pedal-science/pedal-codec/LICENSING.md

# Licensing

This repository holds a hardware design and the software that supports it, so it carries two
licences, chosen by the pedal.science policy in
[../pedal.project/licensing/README.md](https://github.com/pedal-science/pedal.project/blob/main/licensing/README.md).
Both are permissive.

| Licence | Text | Covers |
|---|---|---|
| CERN-OHL-P-2.0 | [LICENSE-CERN-OHL-P](LICENSE-CERN-OHL-P) | Everything not listed below: `hardware/` (the KiCad project, libraries and fab outputs), `docs/`, `bench-results/` |
| MIT | [LICENSE-MIT](LICENSE-MIT) | `overlay/`, `scripts/`, `.github/` |

Copyright 2026 Rik Hemsley. Source location: https://github.com/pedal-science/pedal-codec

## Not ours

- The TAC5242 and every other part's datasheet are their makers' work, and are linked rather than
  kept here.
- KiCad's own symbol, footprint and 3D model libraries stay under KiCad's library licence
  (CC-BY-SA 4.0 with its exception for designs that use them).
