pedal-science/pedal-codec/hardware/pedal-codec.pdf

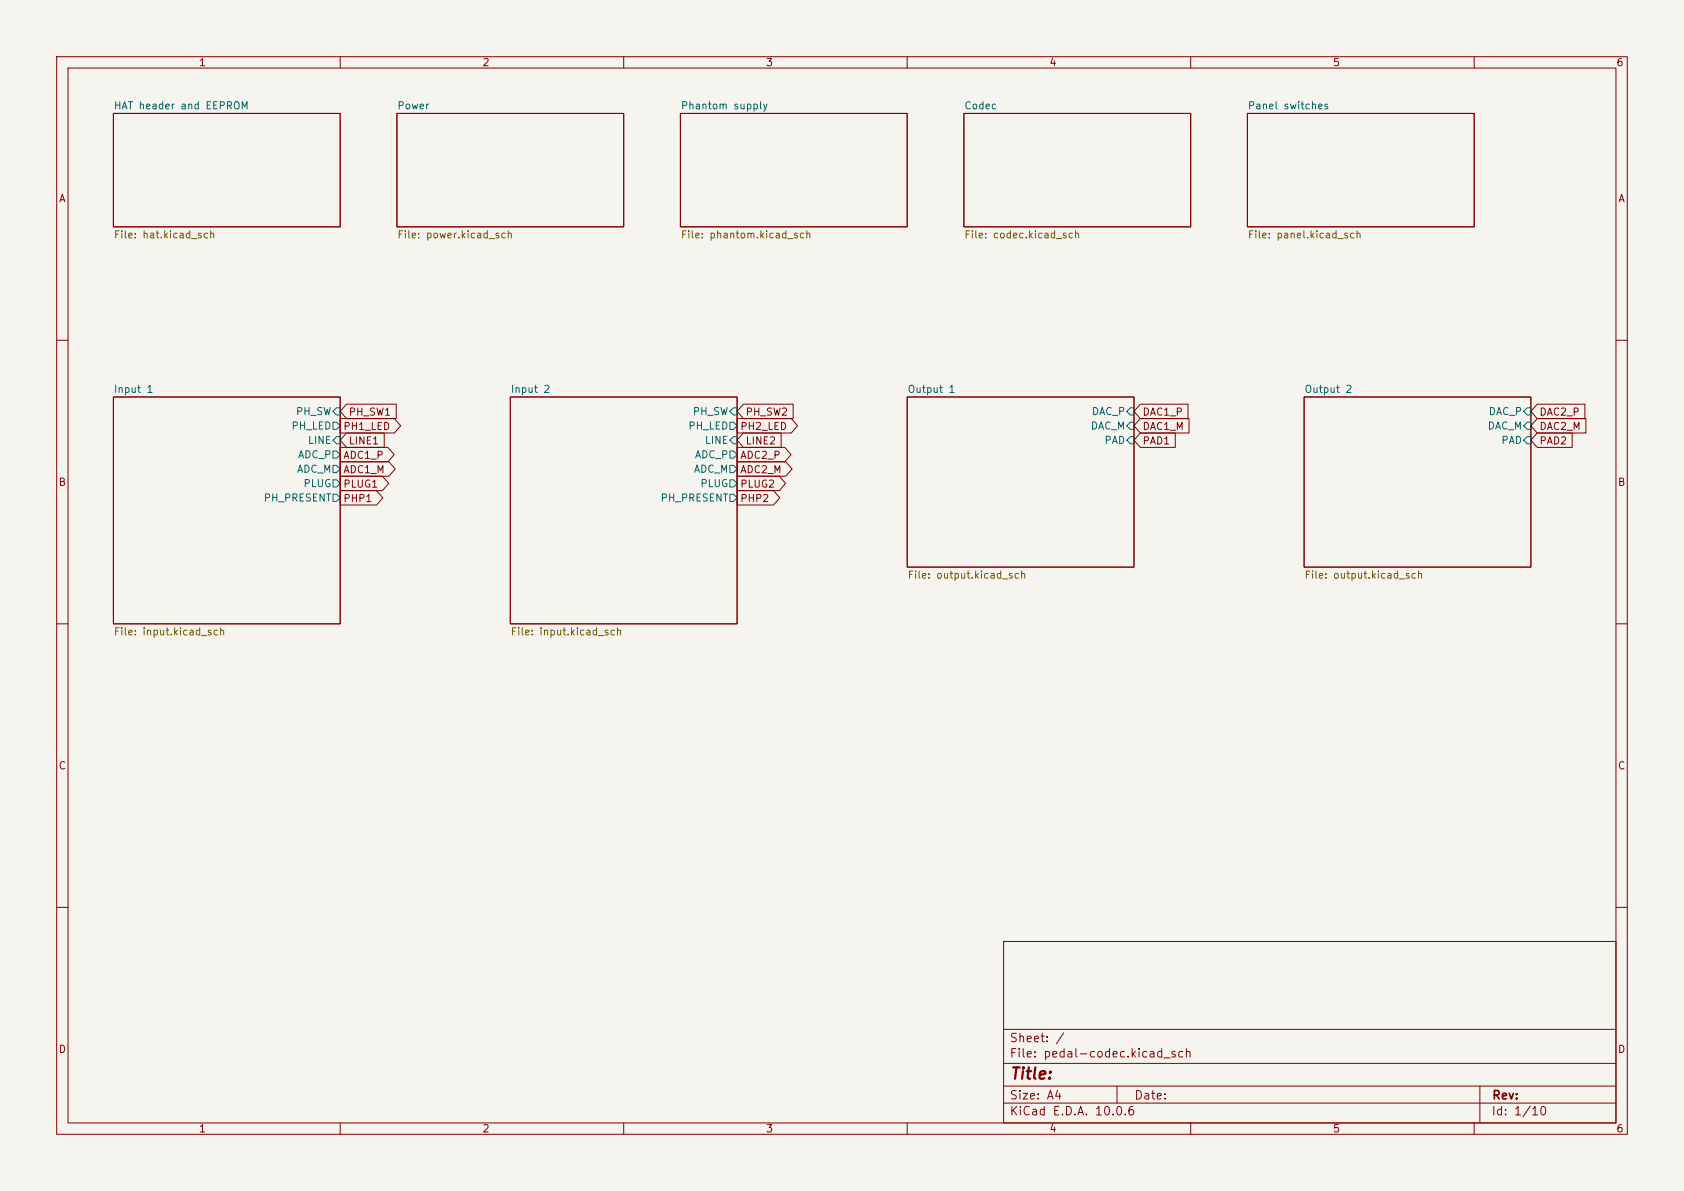
[picture p1: page 1]

File: codec.kicad_sch Phantom supply File: phantom.kicad_sch HAT header and EEPROM

Size: A4 | Rev:
KiCad E.D.A. 10.0.6 | Id: 1/10

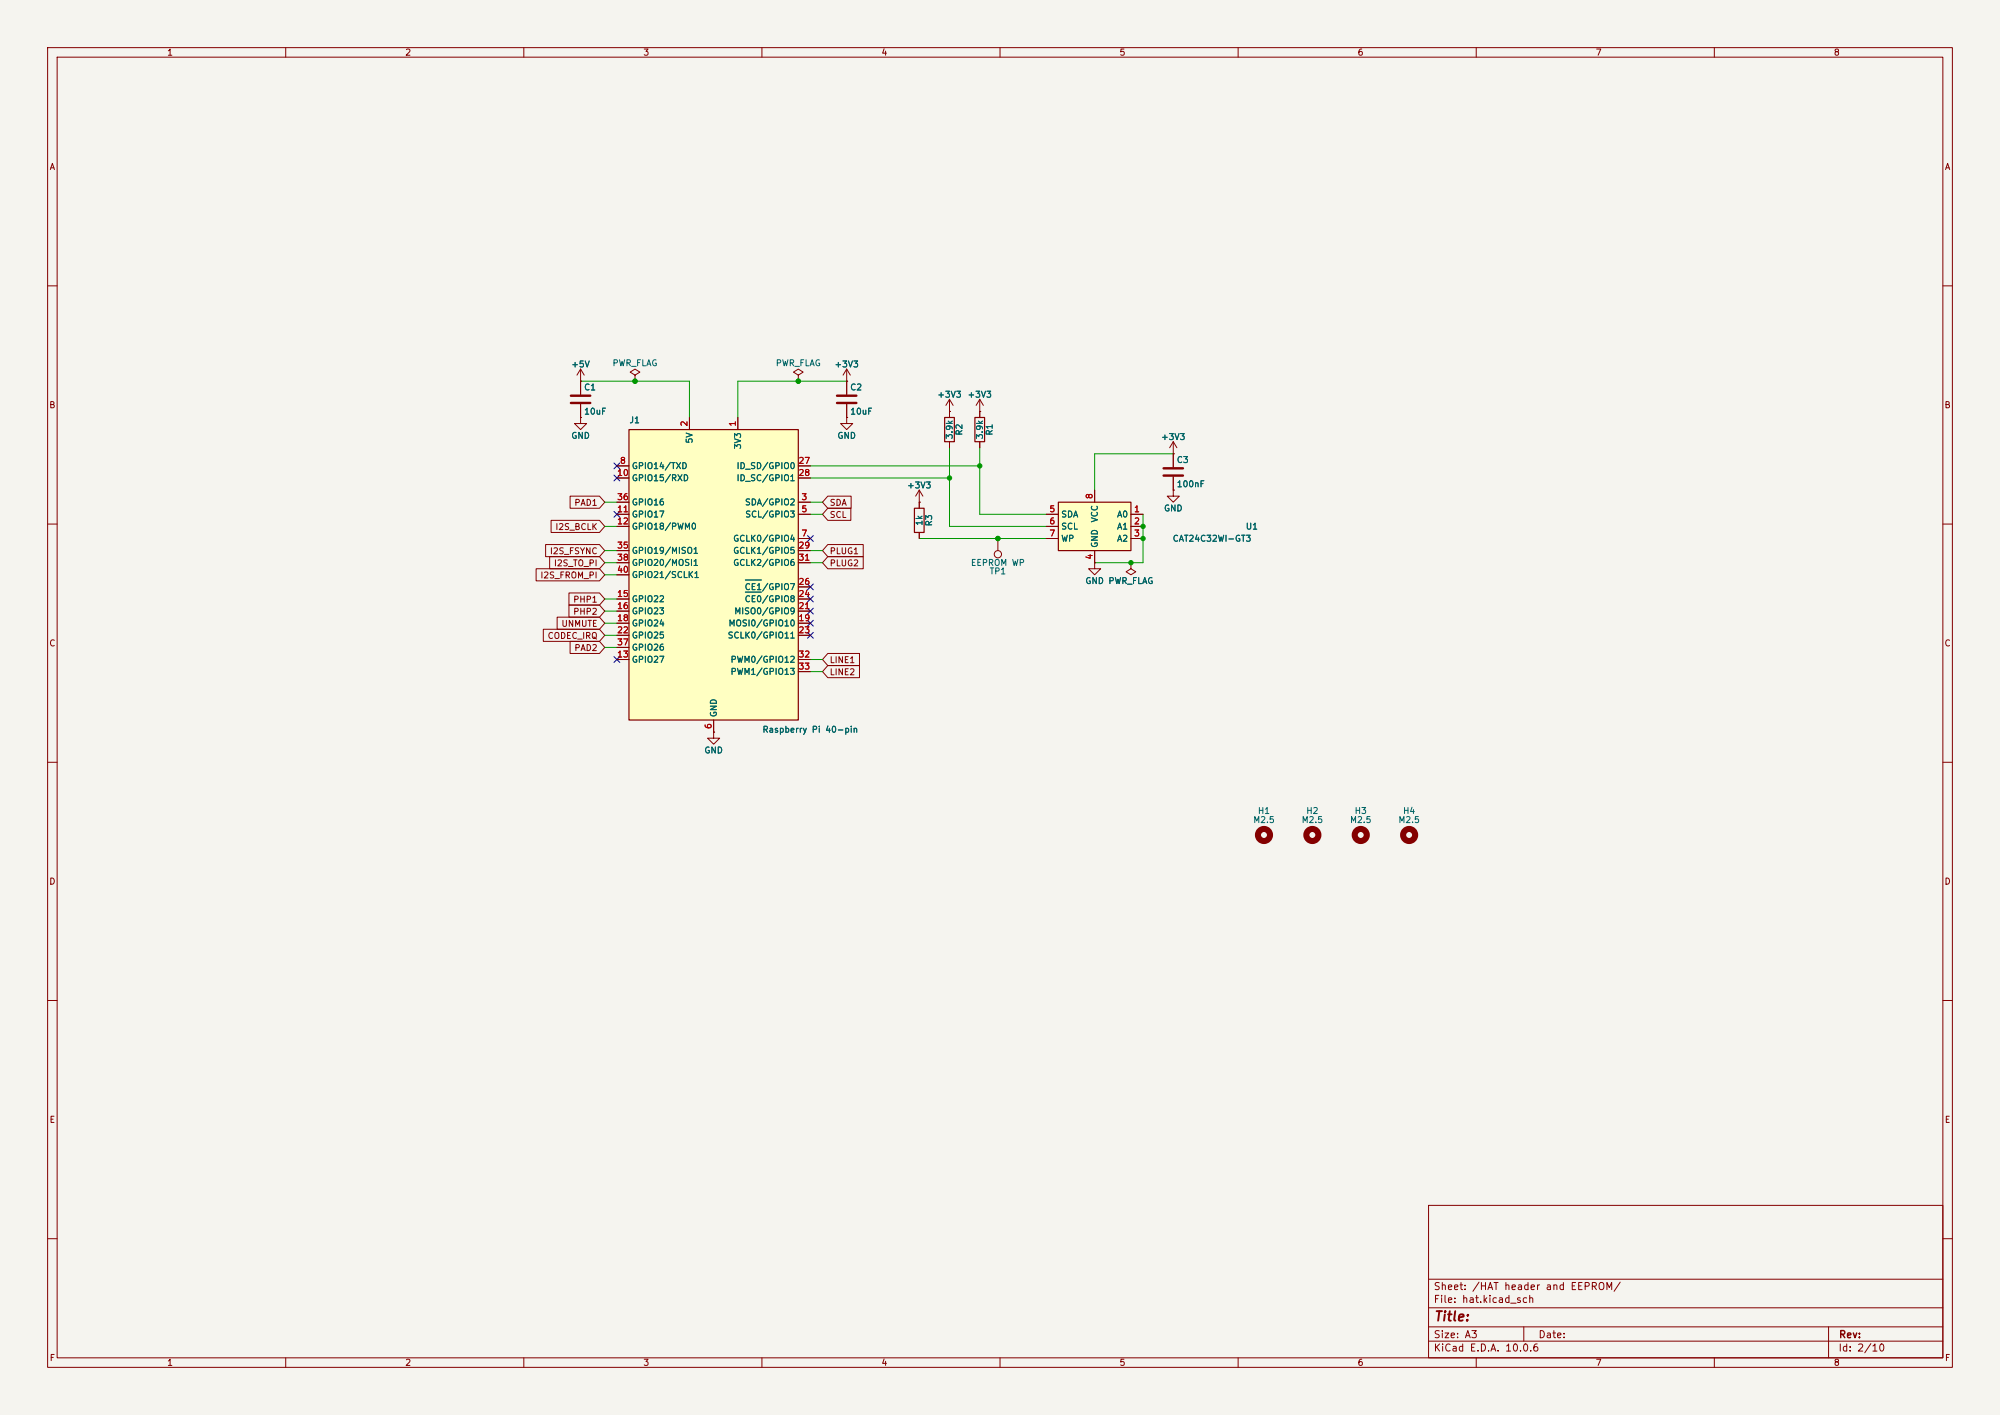
[picture p2: page 2]

Sheet: /HAT header and EEPROM/
File: hat.kicad_sch
Title:

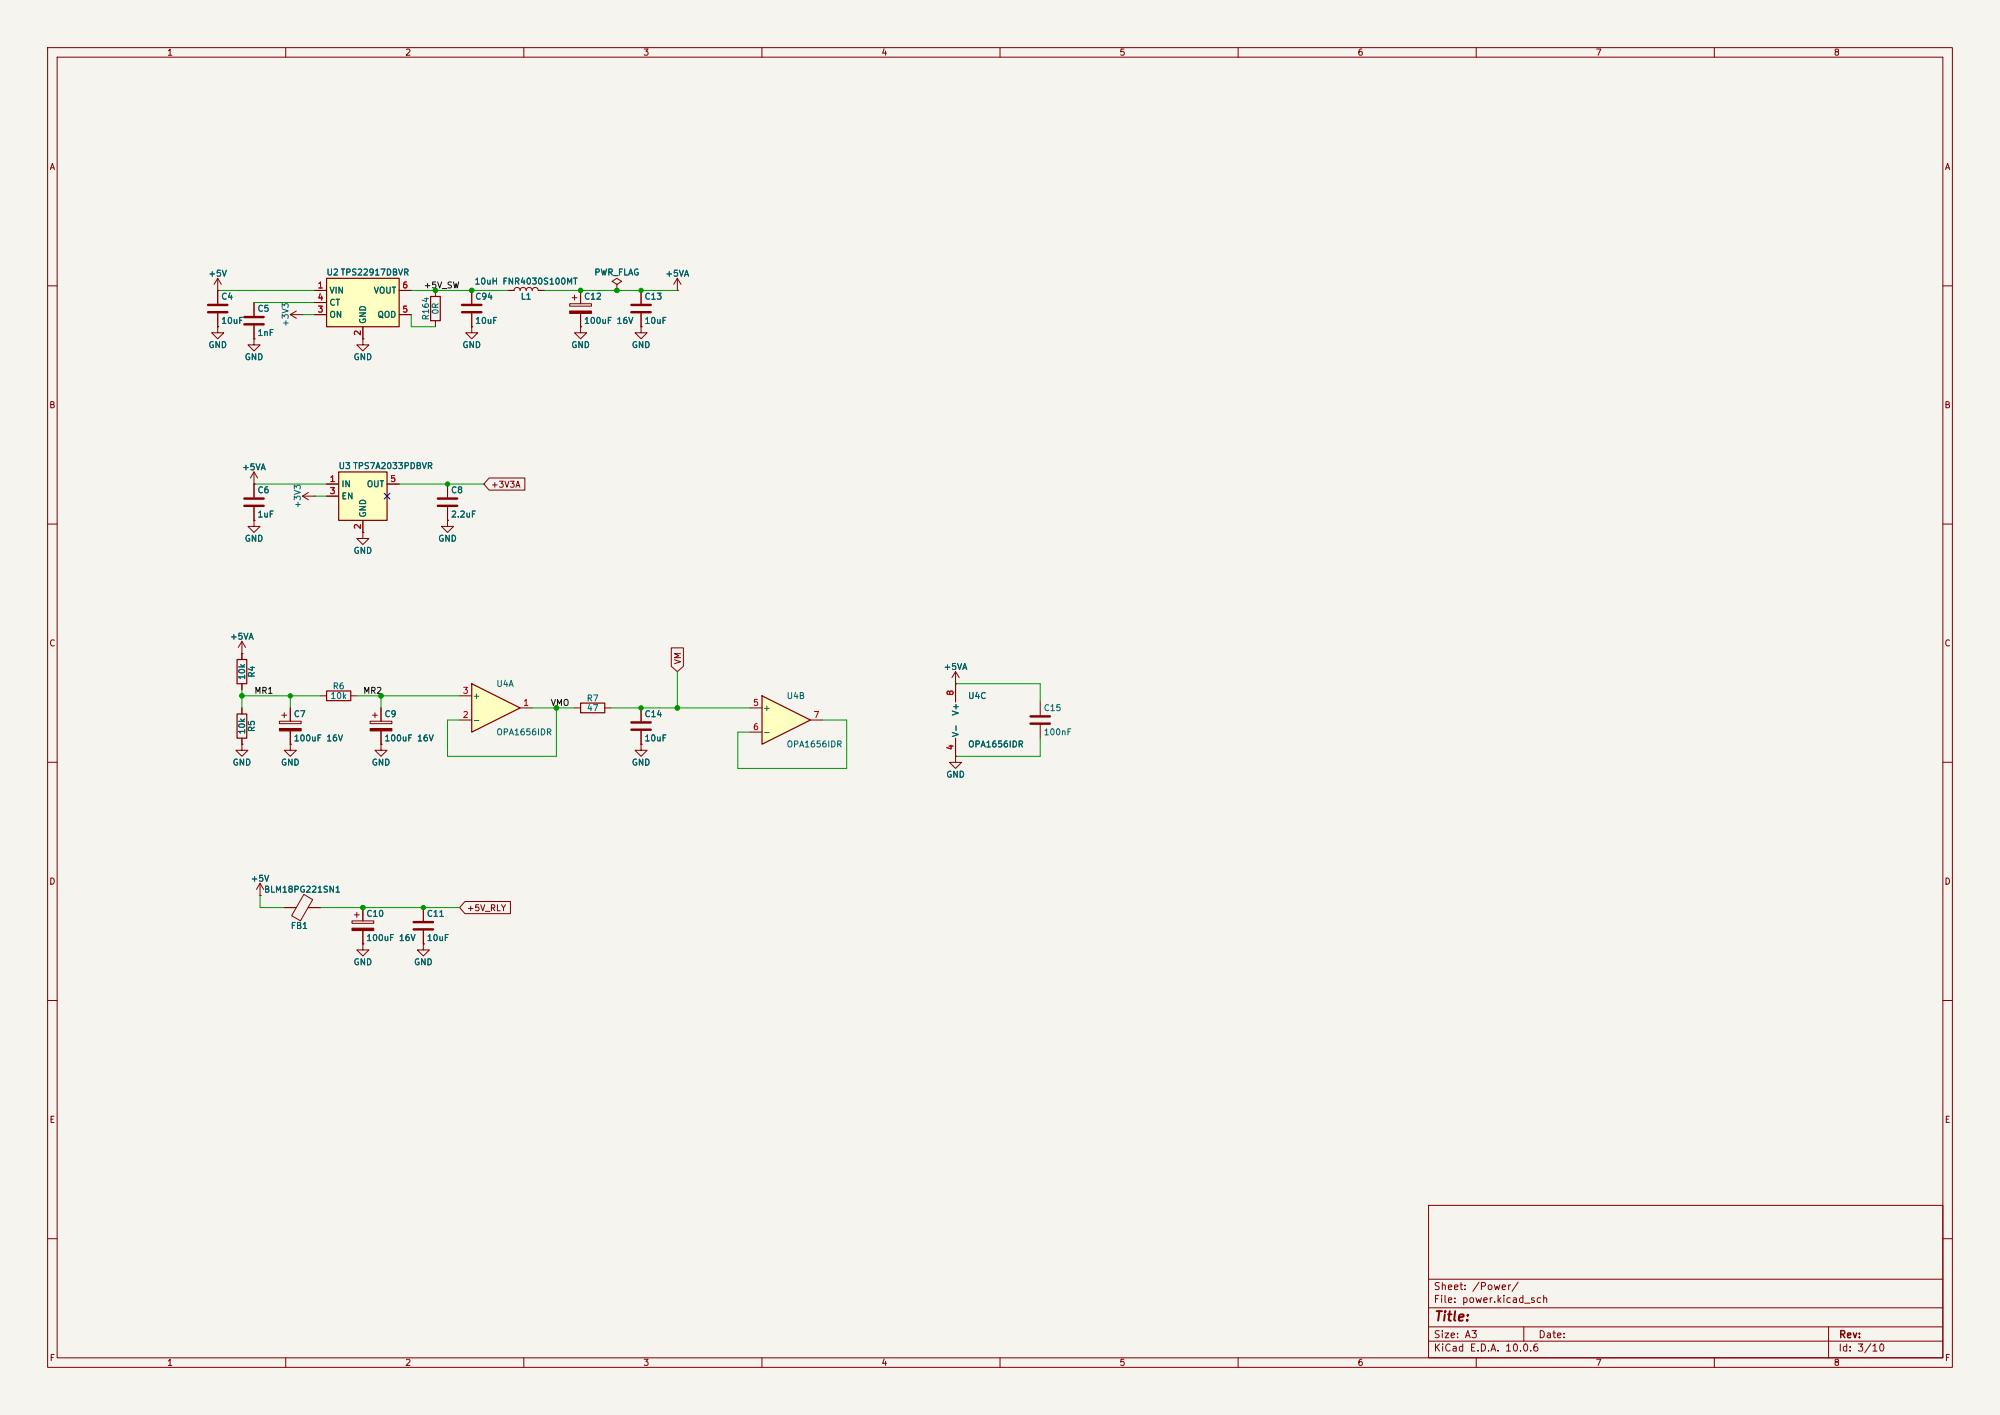
[picture p3: page 3]

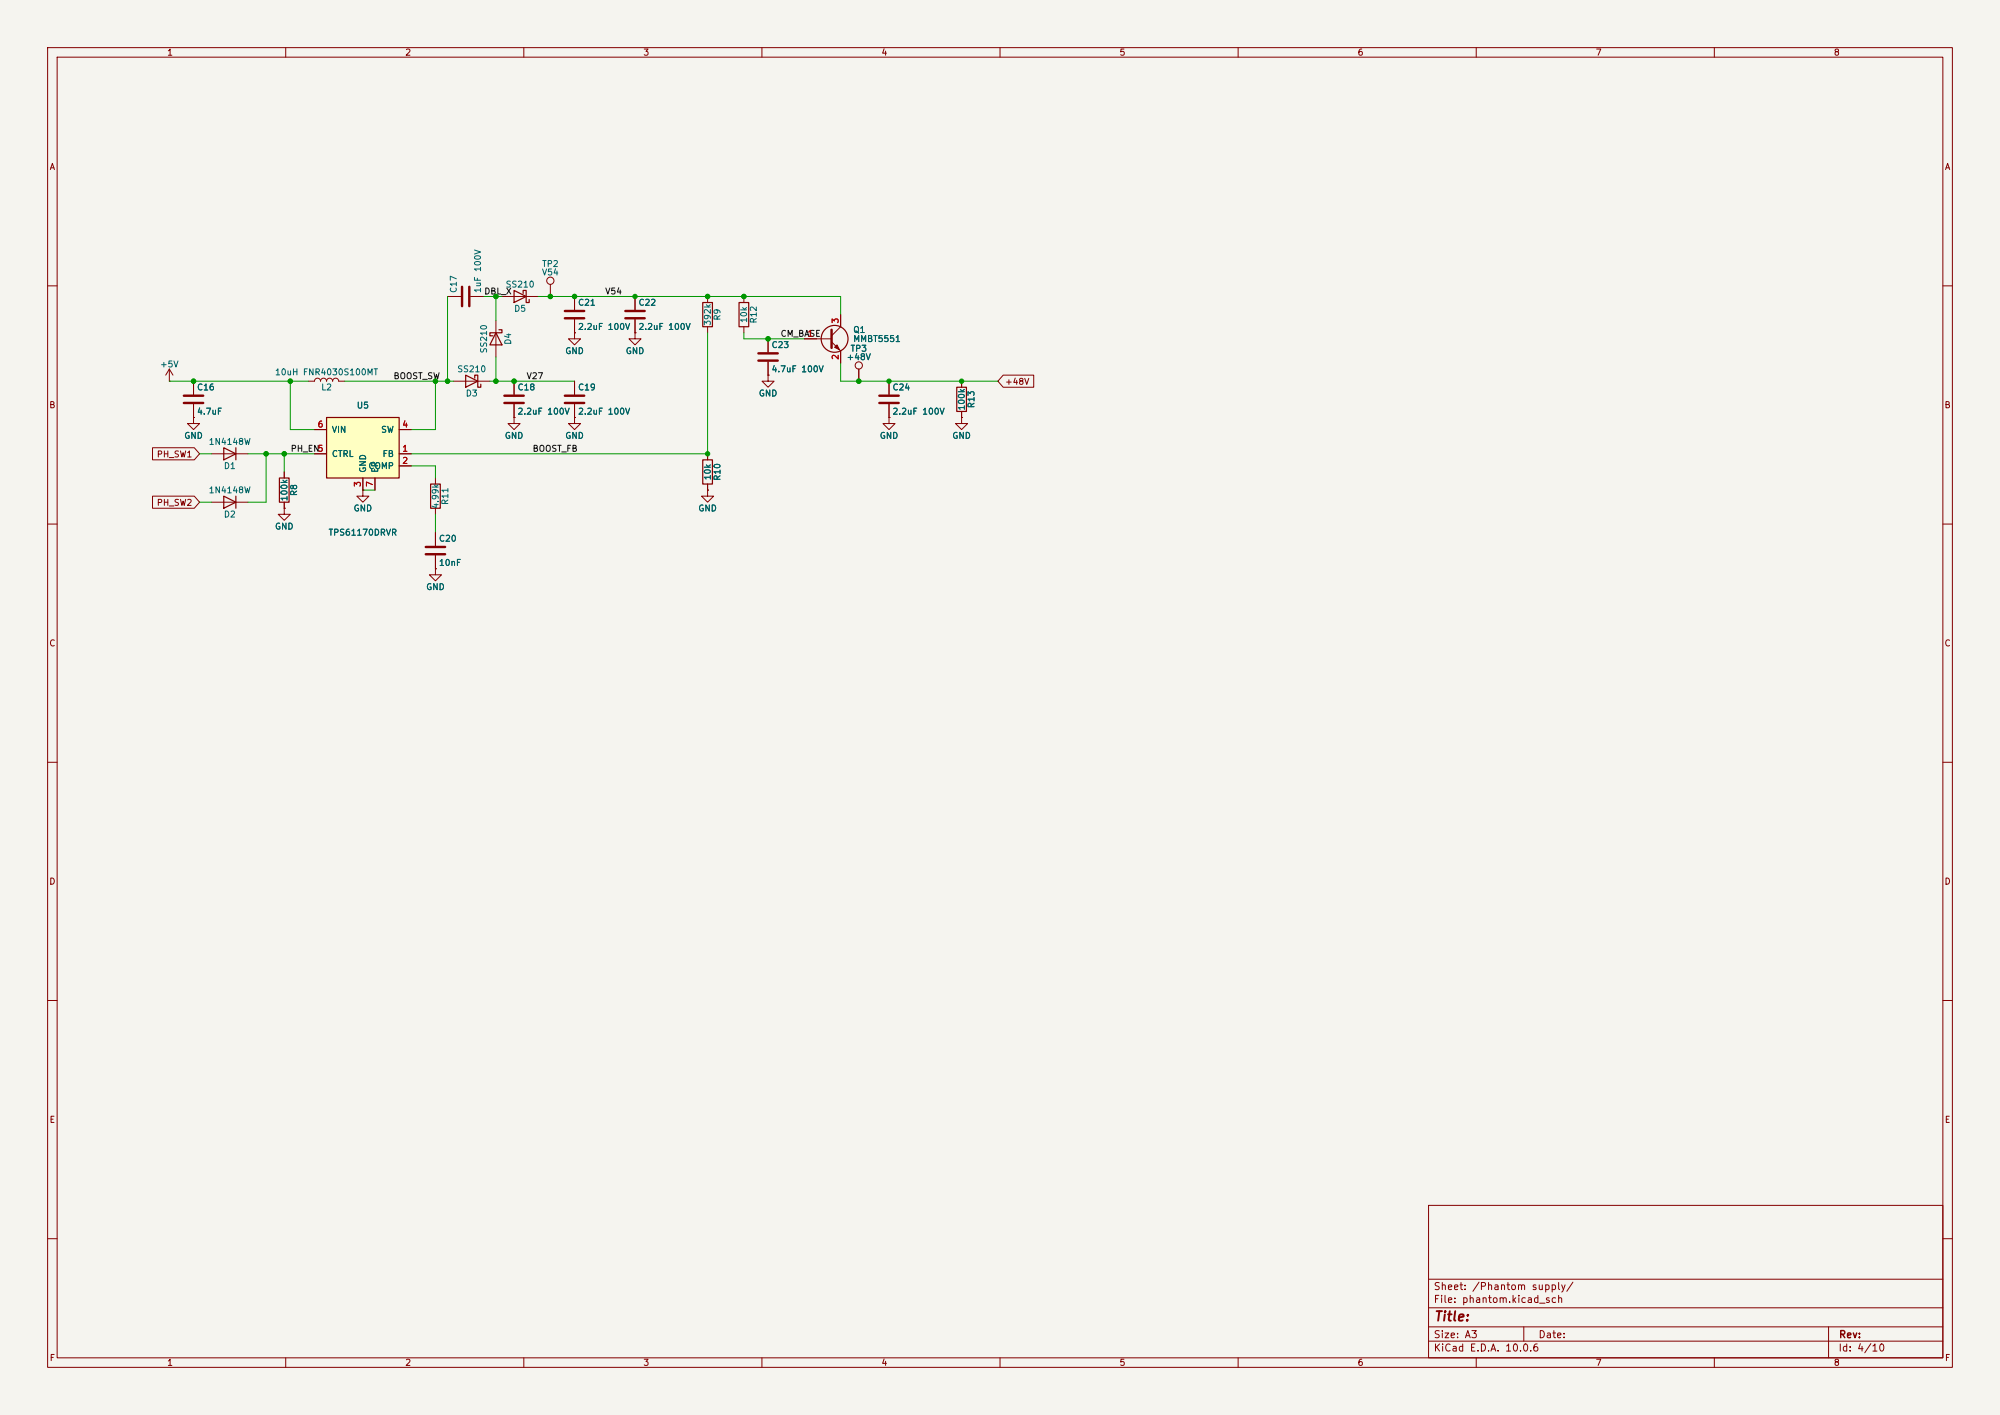
[picture p4: page 4]

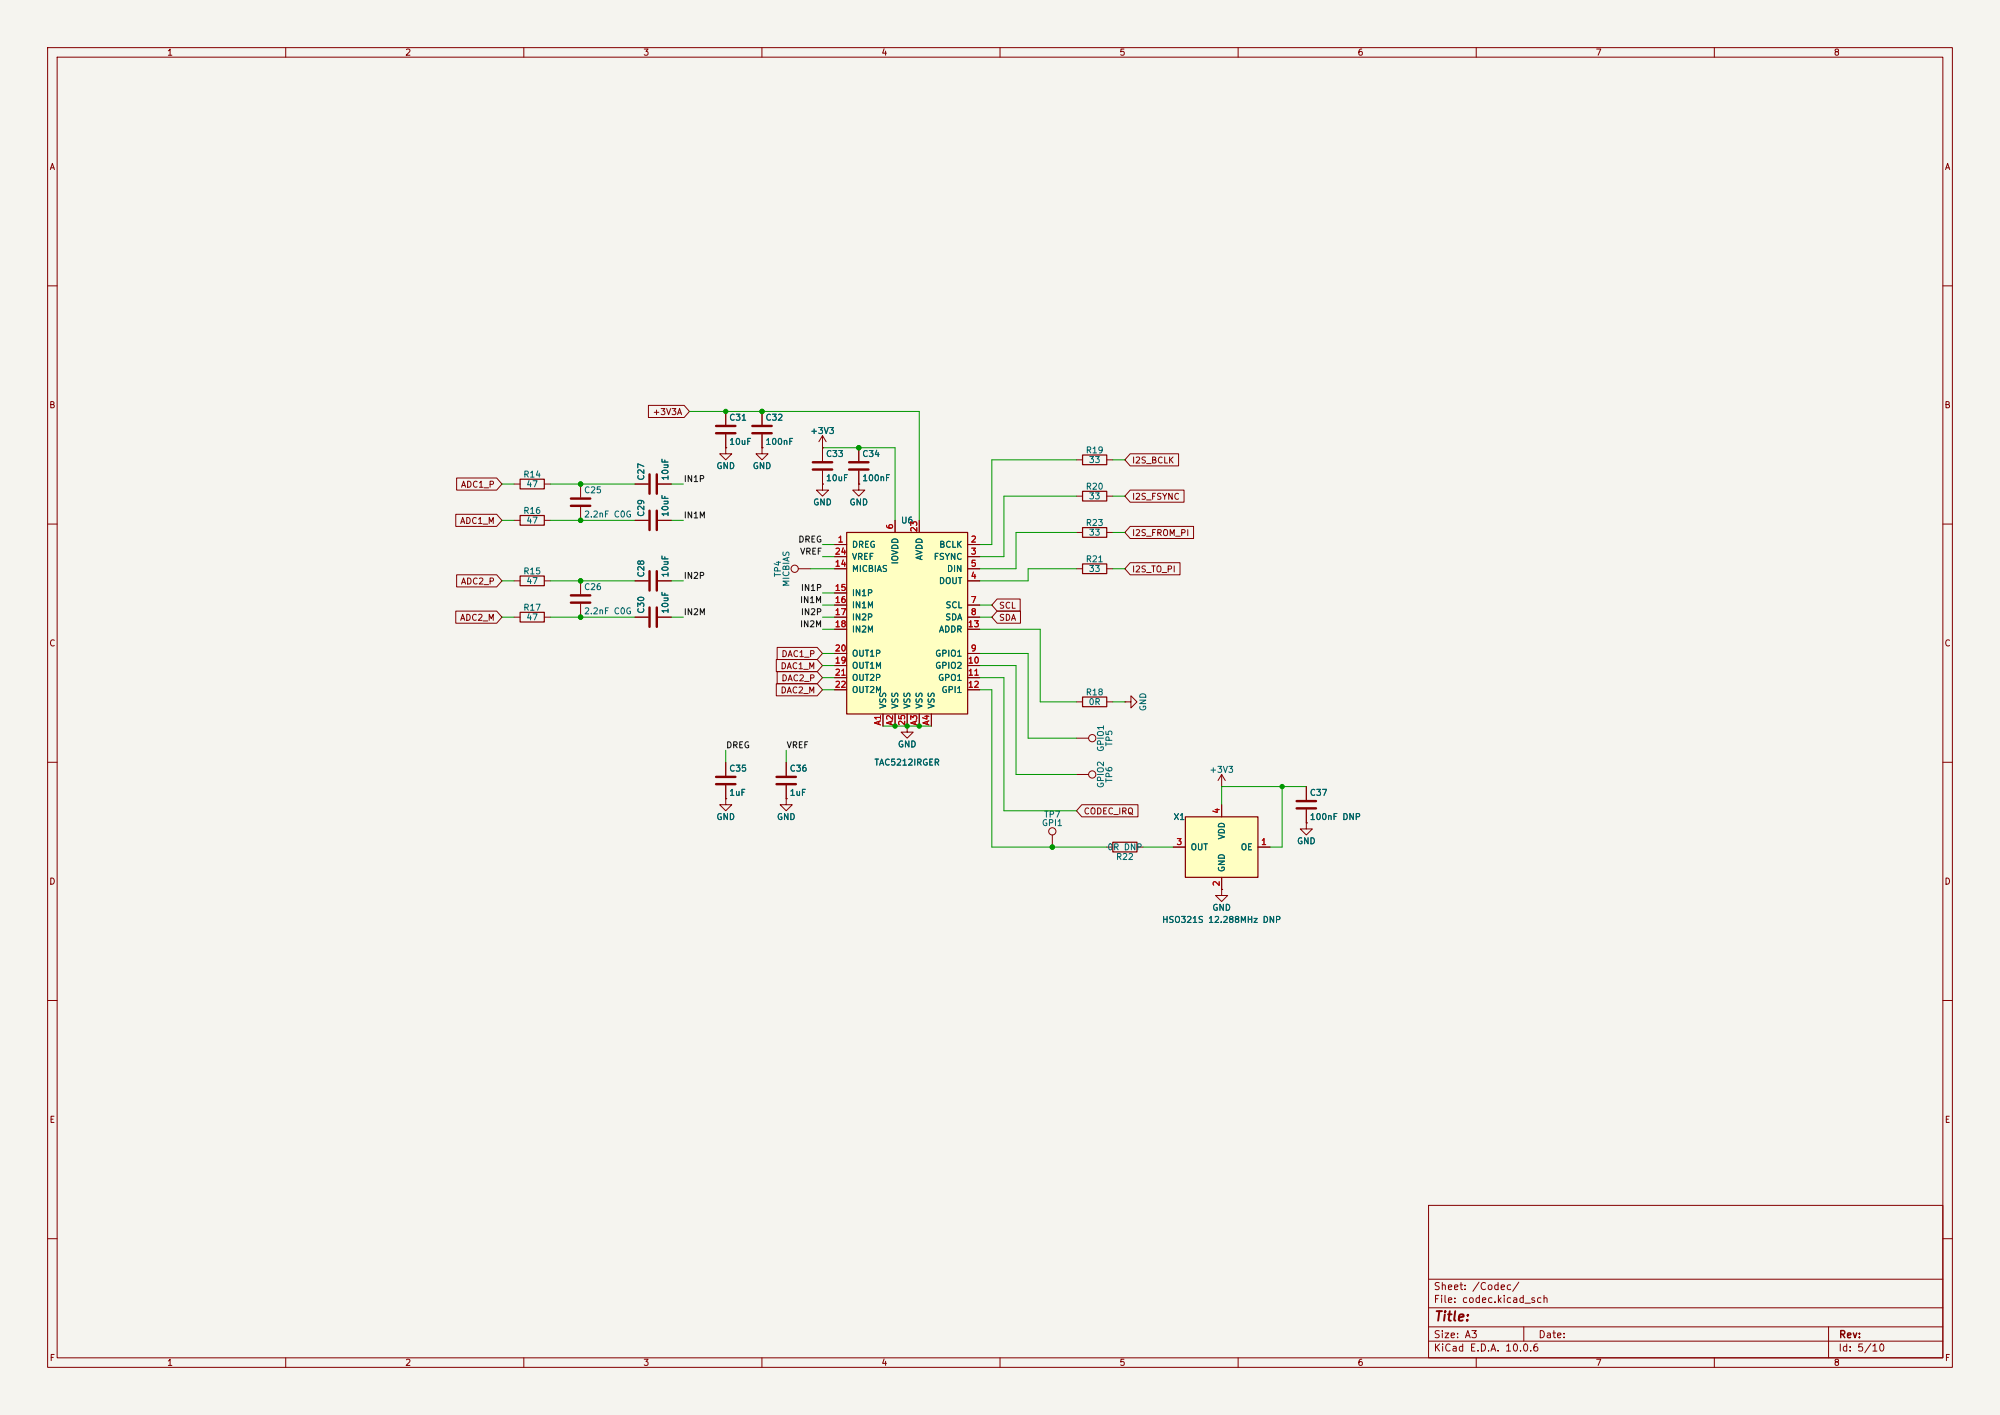
[picture p5: page 5]

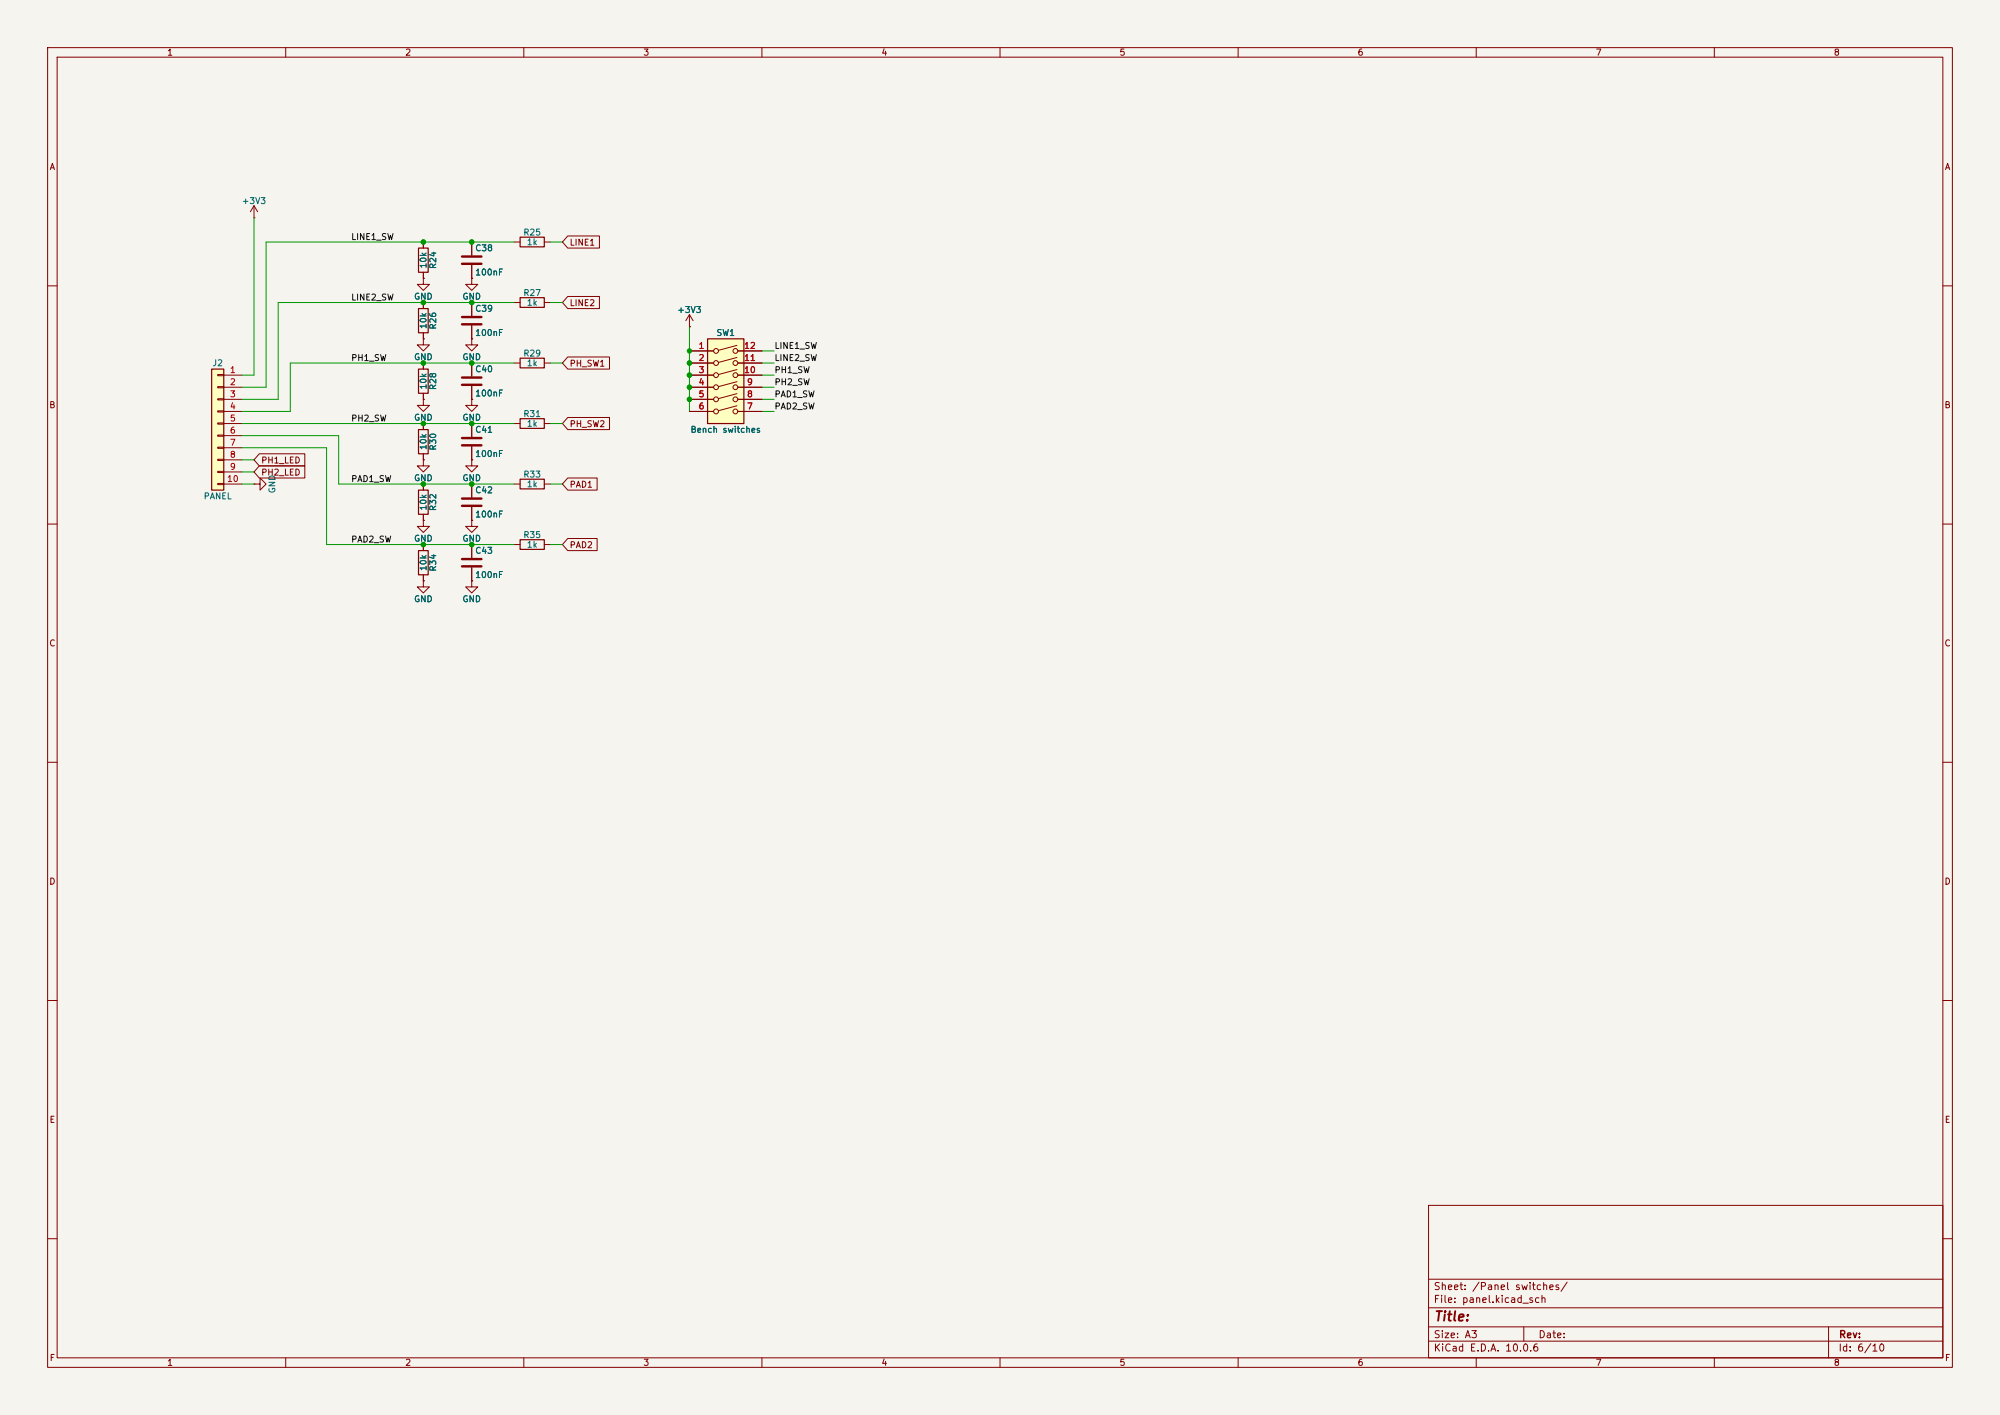
[picture p6: page 6]

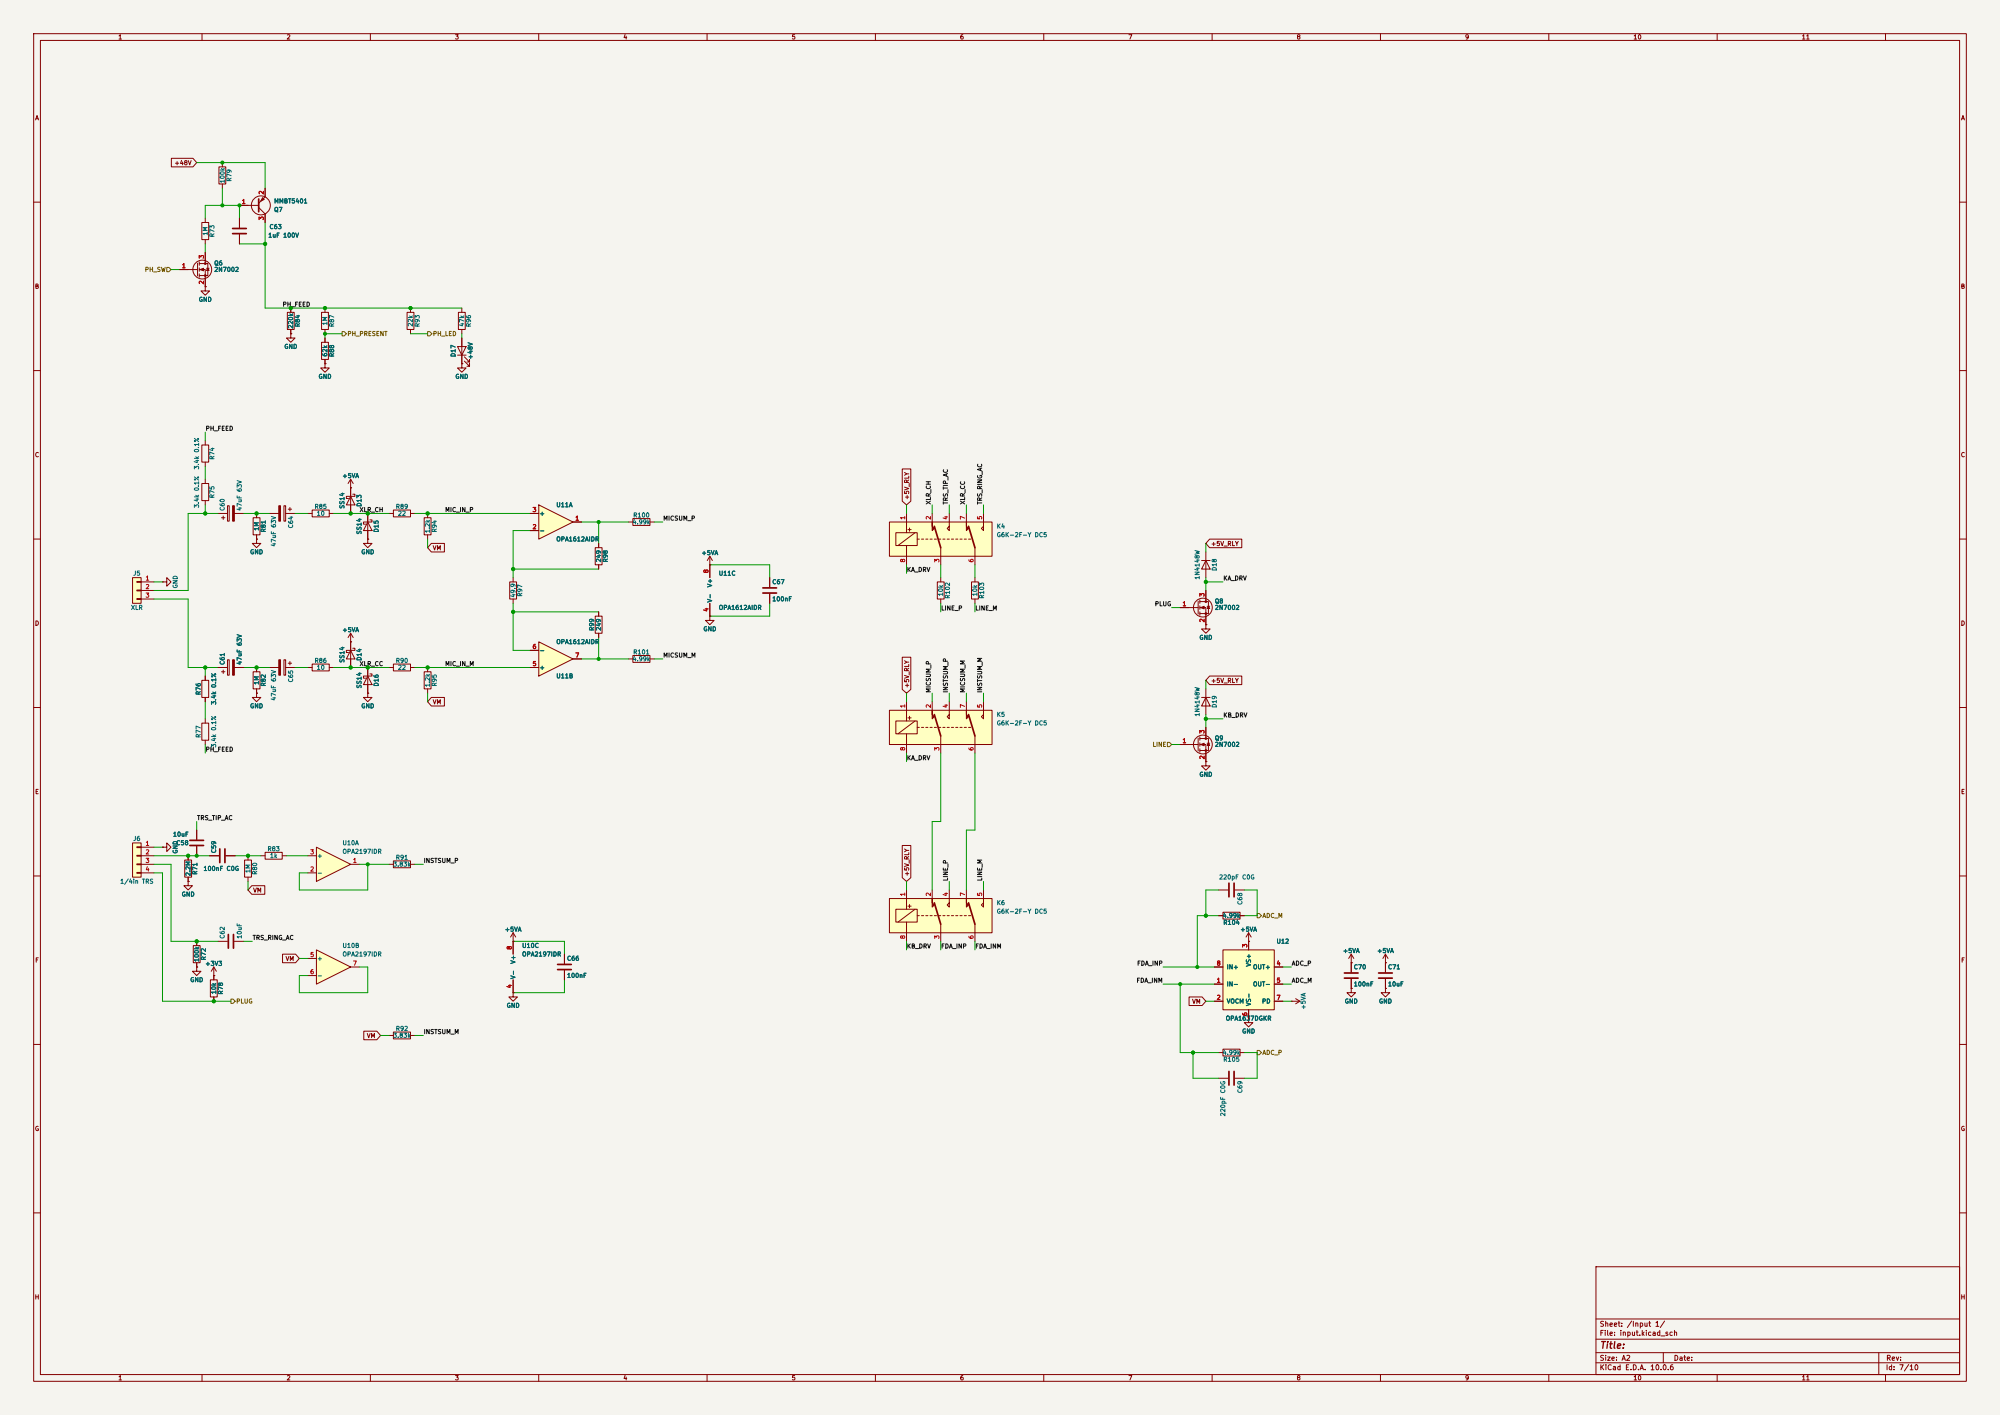
[picture p7: page 7]

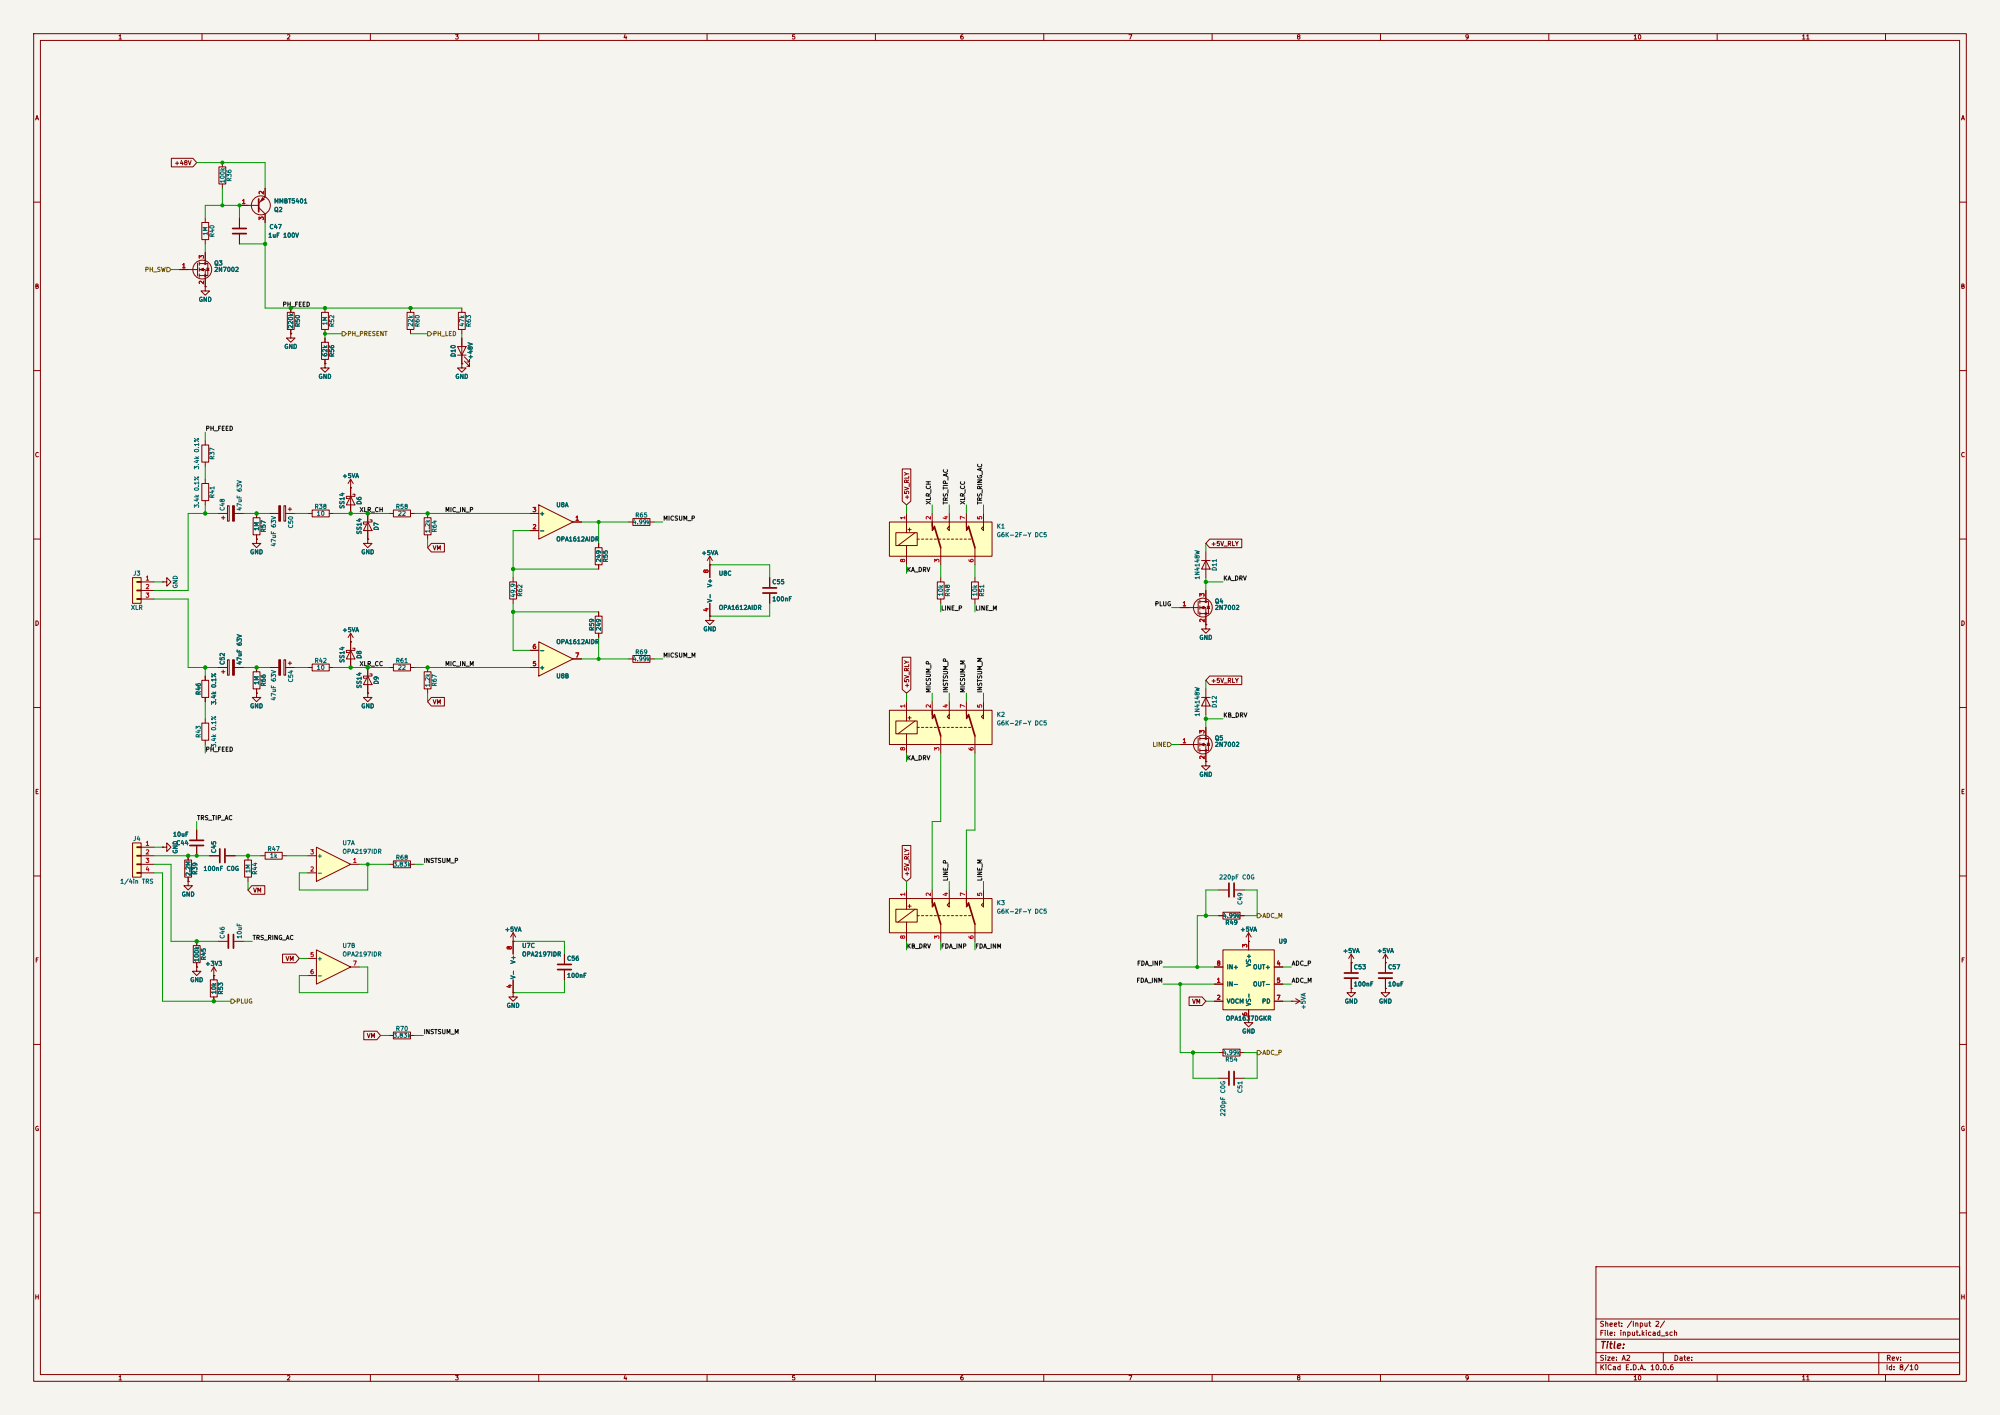
[picture p8: page 8]

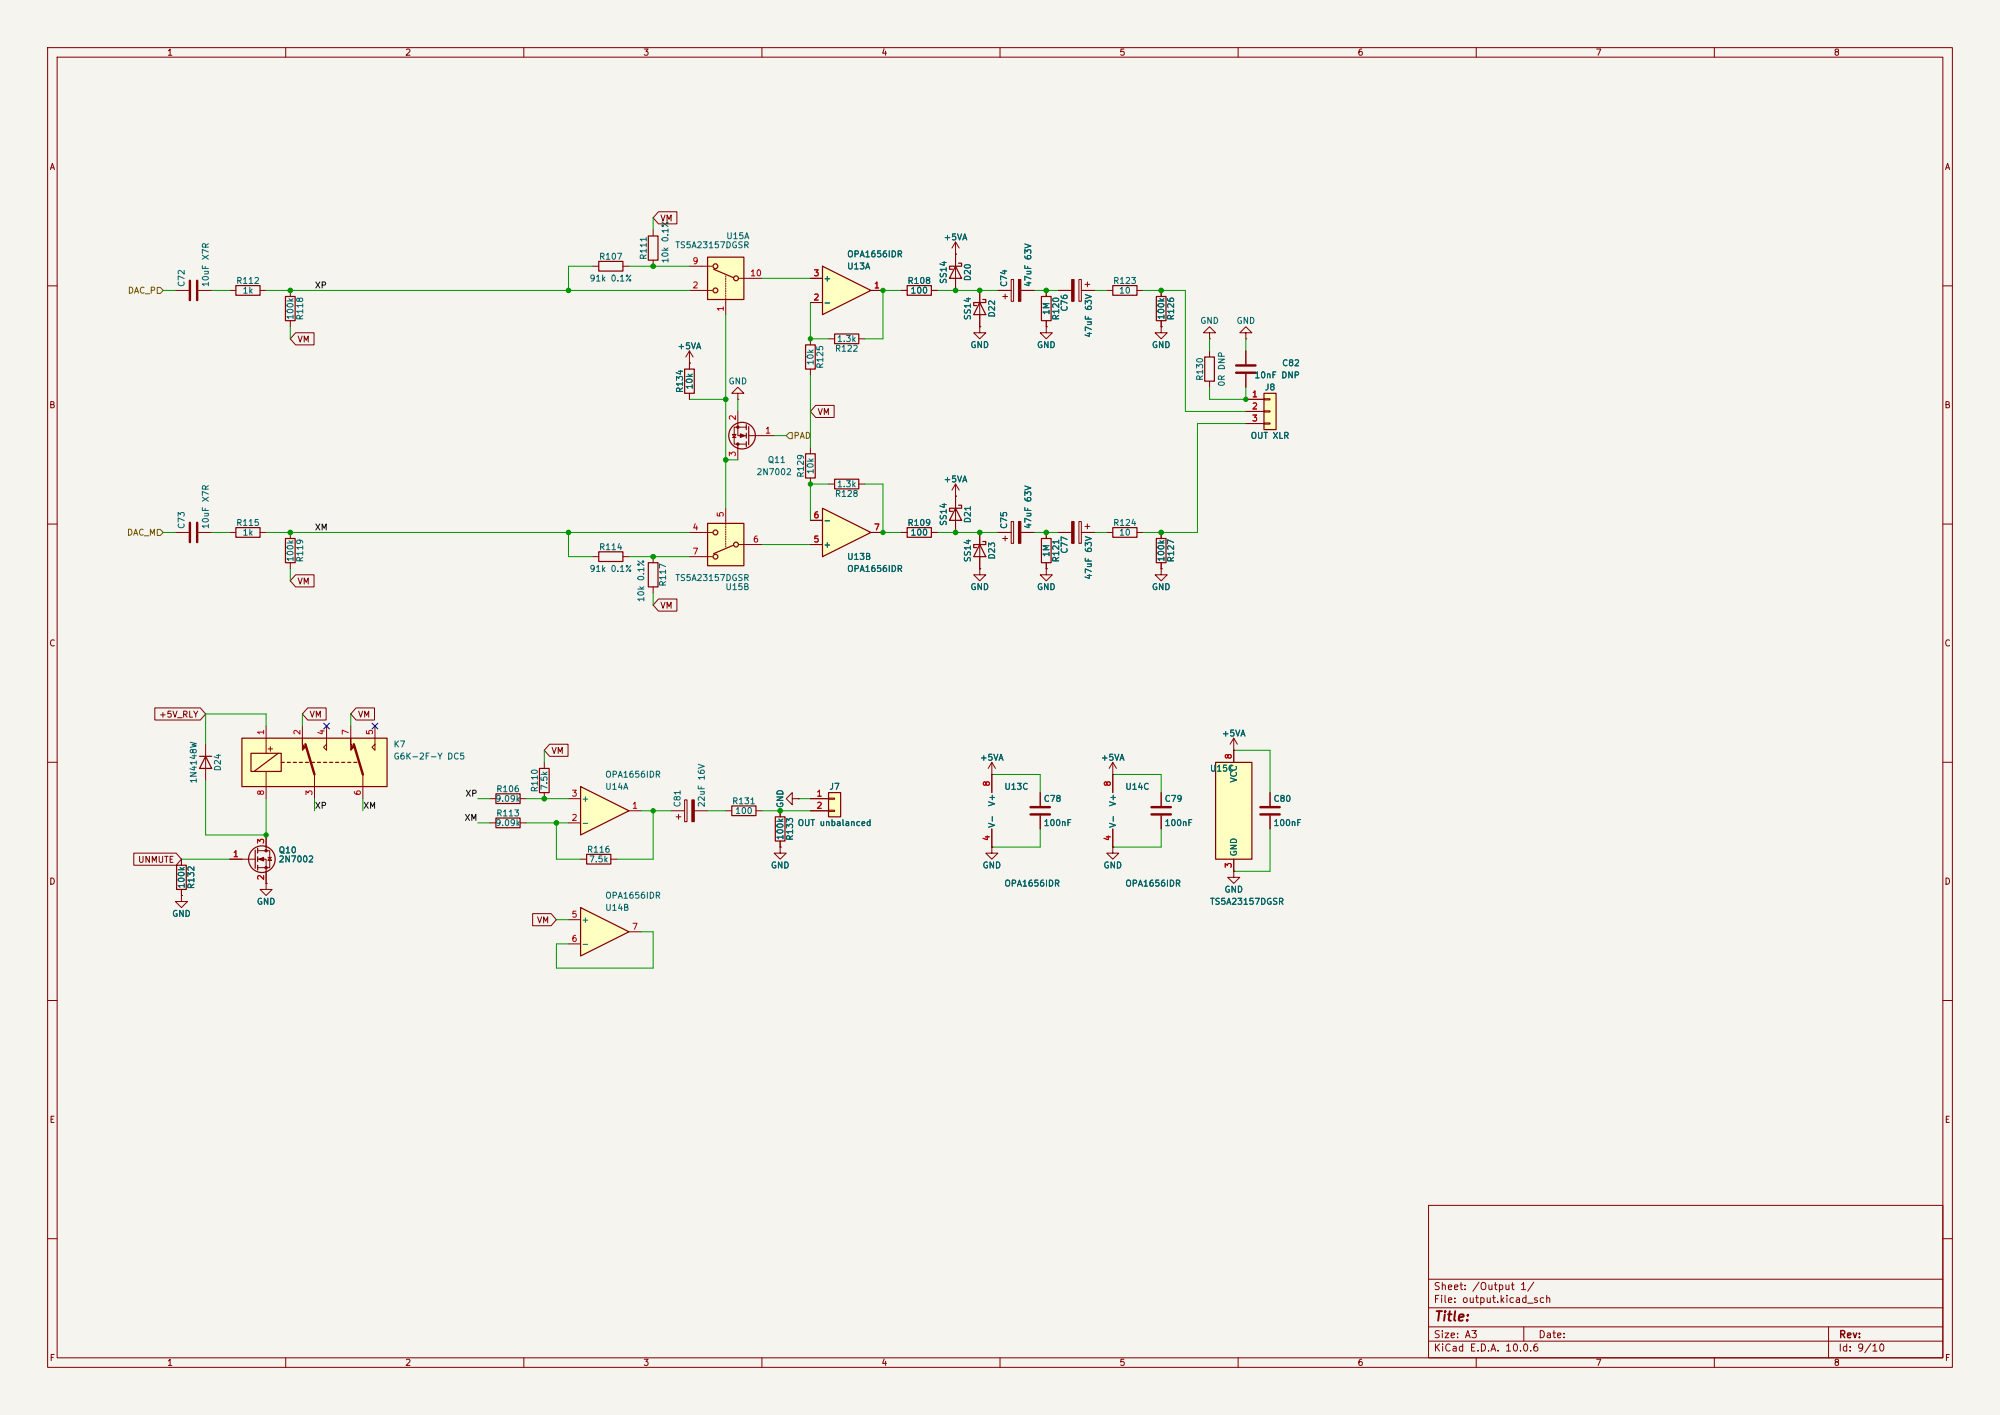
[picture p9: page 9]

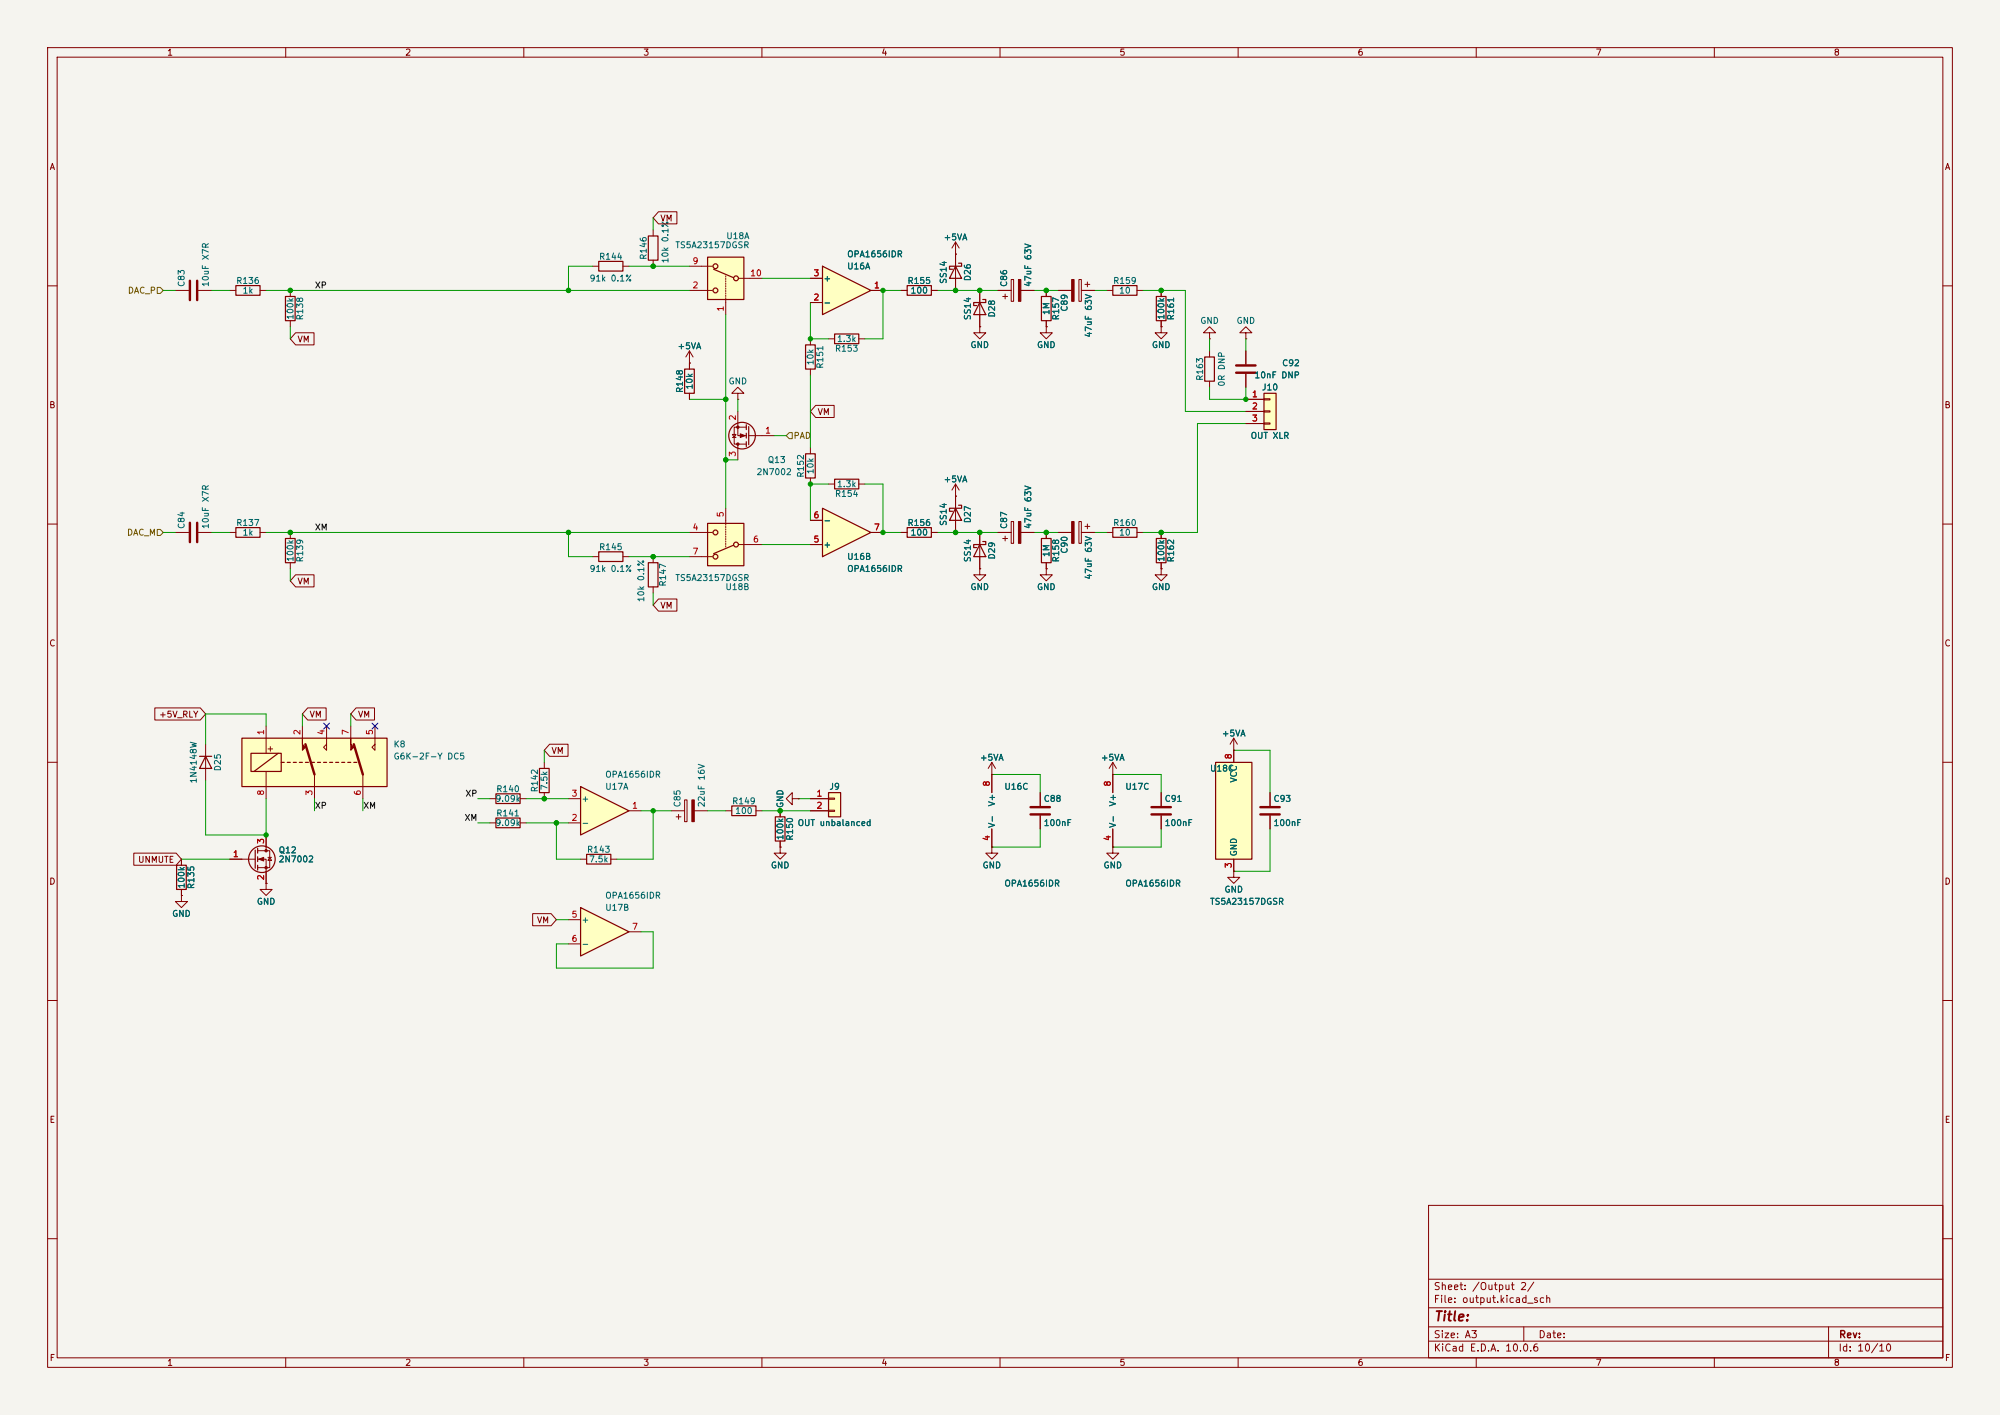
[picture p10: page 10]
