pedal-science/pedal-codec/hardware/codec.kicad_sch

## KiCad design hardware/codec.kicad_sch (2026-11-14, an earlier design)

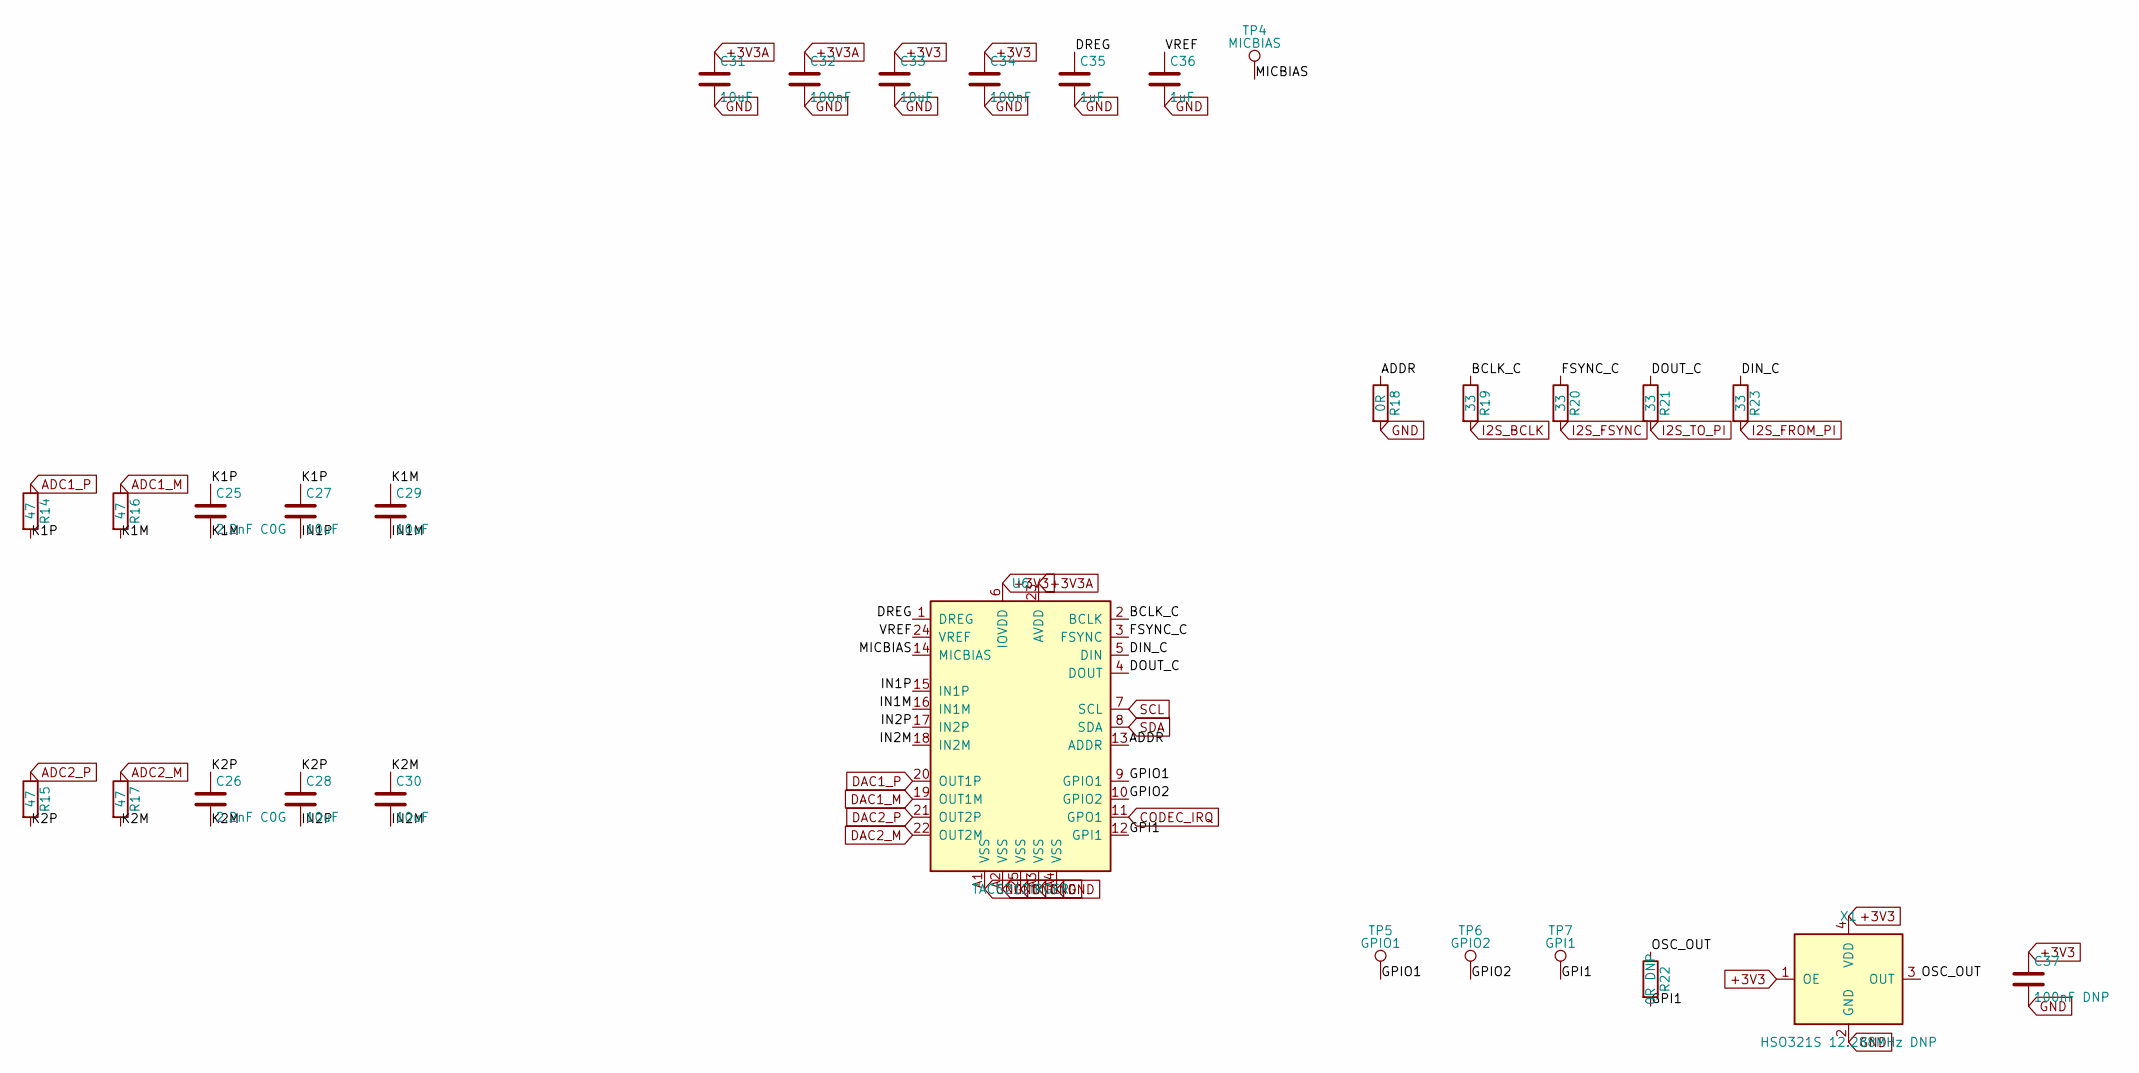
[picture p11: schematic codec.kicad_sch]

Parts:
C25, C26: 2.2nF C0G; C_0603_1608Metric; MPN 0603CG222J500NT; LCSC C2991172
C27, C28, C29, C30, C31, C33: 10uF; C_0805_2012Metric; MPN CL21A106KAYNNNE; LCSC C15850
C32, C34: 100nF; C_0603_1608Metric; MPN CC0603KRX7R9BB104; LCSC C14663
C35, C36: 1uF; C_0603_1608Metric; MPN CL10A105KA8NNNC; LCSC C5673
C37: 100nF DNP; C_0603_1608Metric; MPN CC0603KRX7R9BB104; LCSC C14663
R14, R15, R16, R17: 47; R_0603_1608Metric; MPN 0603WAF470JT5E; LCSC C23182
R18: 0R; R_0603_1608Metric; MPN 0603WAF0000T5E; LCSC C21189
R19, R20, R21, R23: 33; R_0603_1608Metric; MPN 0603WAF330JT5E; LCSC C23140
R22: 0R DNP; R_0603_1608Metric; MPN 0603WAF0000T5E; LCSC C21189
TP4: MICBIAS; TestPoint_Pad_D1.0mm; MPN PCB test pad; LCSC none
TP5: GPIO1; TestPoint_Pad_D1.0mm; MPN PCB test pad; LCSC none
TP6: GPIO2; TestPoint_Pad_D1.0mm; MPN PCB test pad; LCSC none
TP7: GPI1; TestPoint_Pad_D1.0mm; MPN PCB test pad; LCSC none
U6: TAC5212IRGER; Texas_RGE0024H_VQFN-24-1EP_4x4mm_P0.5mm_EP2.7x2.7mm_Thermal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; MPN TAC5212IRGER; LCSC C44853694
X1: HSO321S 12.288MHz DNP; Oscillator_SMD_Abracon_ASE-4Pin_3.2x2.5mm; MPN HSO321S 12.288MHz; LCSC C160458

Connections:
+3V3: C33.1, C34.1, C37.1, U6.6 (IOVDD), X1.1 (OE), X1.4 (VDD)
+3V3A: C31.1, C32.1, U6.23 (AVDD)
ADC1_M: R16.1
ADC1_P: R14.1
ADC2_M: R17.1
ADC2_P: R15.1
ADDR: R18.1, U6.13 (ADDR)
BCLK_C: R19.1, U6.2 (BCLK)
CODEC_IRQ: U6.11 (GPO1)
DAC1_M: U6.19 (OUT1M)
DAC1_P: U6.20 (OUT1P)
DAC2_M: U6.22 (OUT2M)
DAC2_P: U6.21 (OUT2P)
DIN_C: R23.1, U6.5 (DIN)
DOUT_C: R21.1, U6.4 (DOUT)
DREG: C35.1, U6.1 (DREG)
FSYNC_C: R20.1, U6.3 (FSYNC)
GND: C31.2, C32.2, C33.2, C34.2, C35.2, C36.2, C37.2, R18.2, U6.25 (VSS), U6.A1 (VSS), U6.A2 (VSS), U6.A3 (VSS), U6.A4 (VSS), X1.2 (GND)
GPI1: R22.2, TP7.1, U6.12 (GPI1)
GPIO1: TP5.1, U6.9 (GPIO1)
GPIO2: TP6.1, U6.10 (GPIO2)
I2S_BCLK: R19.2
I2S_FROM_PI: R23.2
I2S_FSYNC: R20.2
I2S_TO_PI: R21.2
IN1M: C29.2, U6.16 (IN1M)
IN1P: C27.2, U6.15 (IN1P)
IN2M: C30.2, U6.18 (IN2M)
IN2P: C28.2, U6.17 (IN2P)
K1M: C25.2, C29.1, R16.2
K1P: C25.1, C27.1, R14.2
K2M: C26.2, C30.1, R17.2
K2P: C26.1, C28.1, R15.2
MICBIAS: TP4.1, U6.14 (MICBIAS)
OSC_OUT: R22.1, X1.3 (OUT)
SCL: U6.7 (SCL)
SDA: U6.8 (SDA)
VREF: C36.1, U6.24 (VREF)
