pedal-science/pedal-codec/hardware/hat.kicad_sch

## KiCad design hardware/hat.kicad_sch (2026-11-14, an earlier design)

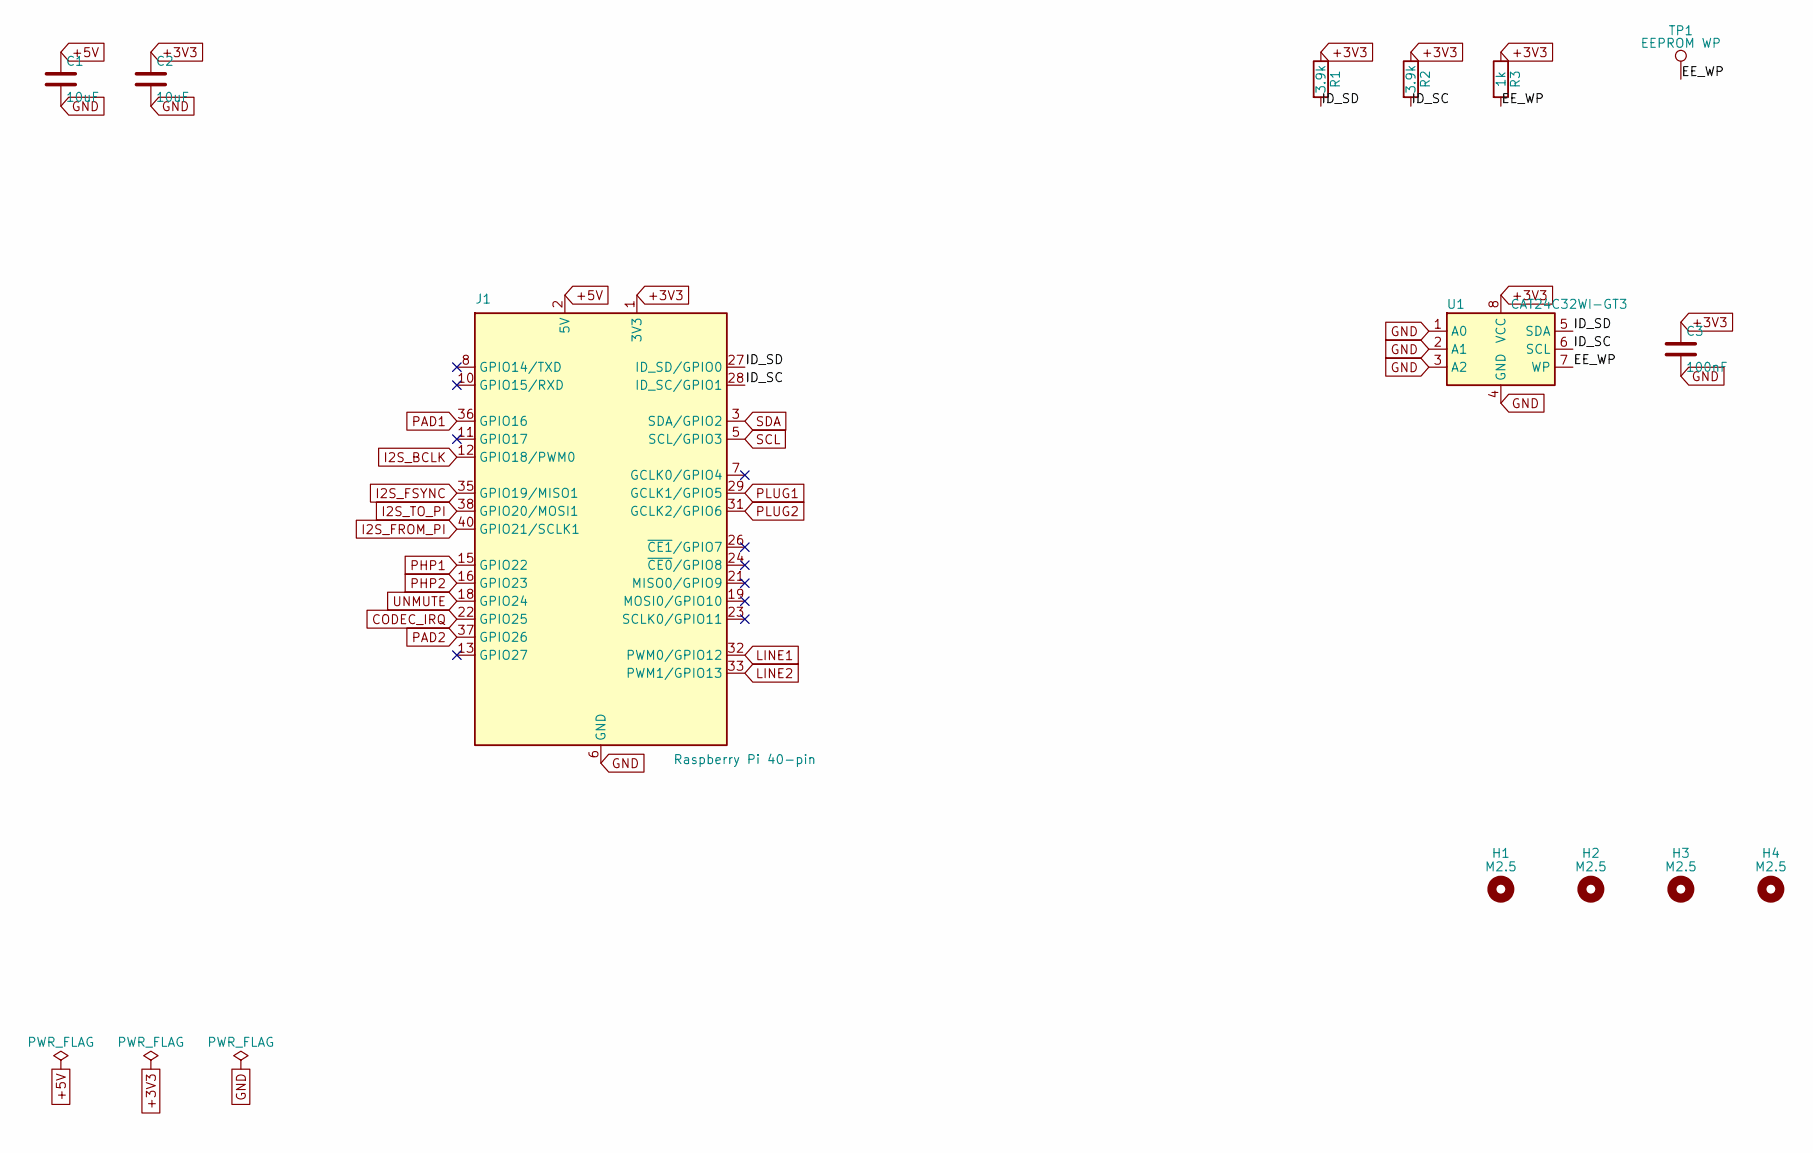
[picture p12: schematic hat.kicad_sch]

Parts:
C1, C2: 10uF; C_0805_2012Metric; MPN CL21A106KAYNNNE; LCSC C15850
C3: 100nF; C_0603_1608Metric; MPN CC0603KRX7R9BB104; LCSC C14663
H1, H2, H3, H4: M2.5; MountingHole_2.7mm_M2.5; MPN PCB mounting hole; LCSC none
J1: Raspberry Pi 40-pin; PinSocket_2x20_P2.54mm_Vertical; MPN 2.54-2*20 (2x20 female header); LCSC C2977589
R1, R2: 3.9k; R_0603_1608Metric; MPN 0603WAF3901T5E; LCSC C23018
R3: 1k; R_0603_1608Metric; MPN 0603WAF1001T5E; LCSC C21190
TP1: EEPROM WP; TestPoint_Pad_D1.0mm; MPN PCB test pad; LCSC none
U1: CAT24C32WI-GT3; SOIC-8_3.9x4.9mm_P1.27mm; MPN CAT24C32WI-GT3; LCSC C81193

Connections:
+3V3: C2.1, C3.1, J1.1 (3V3), J1.17 (3V3), R1.1, R2.1, R3.1, U1.8 (VCC)
+5V: C1.1, J1.2 (5V), J1.4 (5V)
CODEC_IRQ: J1.22 (GPIO25)
EE_WP: R3.2, TP1.1, U1.7 (WP)
GND: C1.2, C2.2, C3.2, J1.6 (GND), J1.9 (GND), J1.14 (GND), J1.20 (GND), J1.25 (GND), J1.30 (GND), J1.34 (GND), J1.39 (GND), U1.1 (A0), U1.2 (A1), U1.3 (A2), U1.4 (GND)
I2S_BCLK: J1.12 (GPIO18/PWM0)
I2S_FROM_PI: J1.40 (GPIO21/SCLK1)
I2S_FSYNC: J1.35 (GPIO19/MISO1)
I2S_TO_PI: J1.38 (GPIO20/MOSI1)
ID_SC: J1.28 (ID_SC/GPIO1), R2.2, U1.6 (SCL)
ID_SD: J1.27 (ID_SD/GPIO0), R1.2, U1.5 (SDA)
LINE1: J1.32 (PWM0/GPIO12)
LINE2: J1.33 (PWM1/GPIO13)
PAD1: J1.36 (GPIO16)
PAD2: J1.37 (GPIO26)
PHP1: J1.15 (GPIO22)
PHP2: J1.16 (GPIO23)
PLUG1: J1.29 (GCLK1/GPIO5)
PLUG2: J1.31 (GCLK2/GPIO6)
SCL: J1.5 (SCL/GPIO3)
SDA: J1.3 (SDA/GPIO2)
UNMUTE: J1.18 (GPIO24)
