pedal-science/pedal-codec/hardware/input.kicad_sch

## KiCad design hardware/input.kicad_sch (2026-11-14, an earlier design)

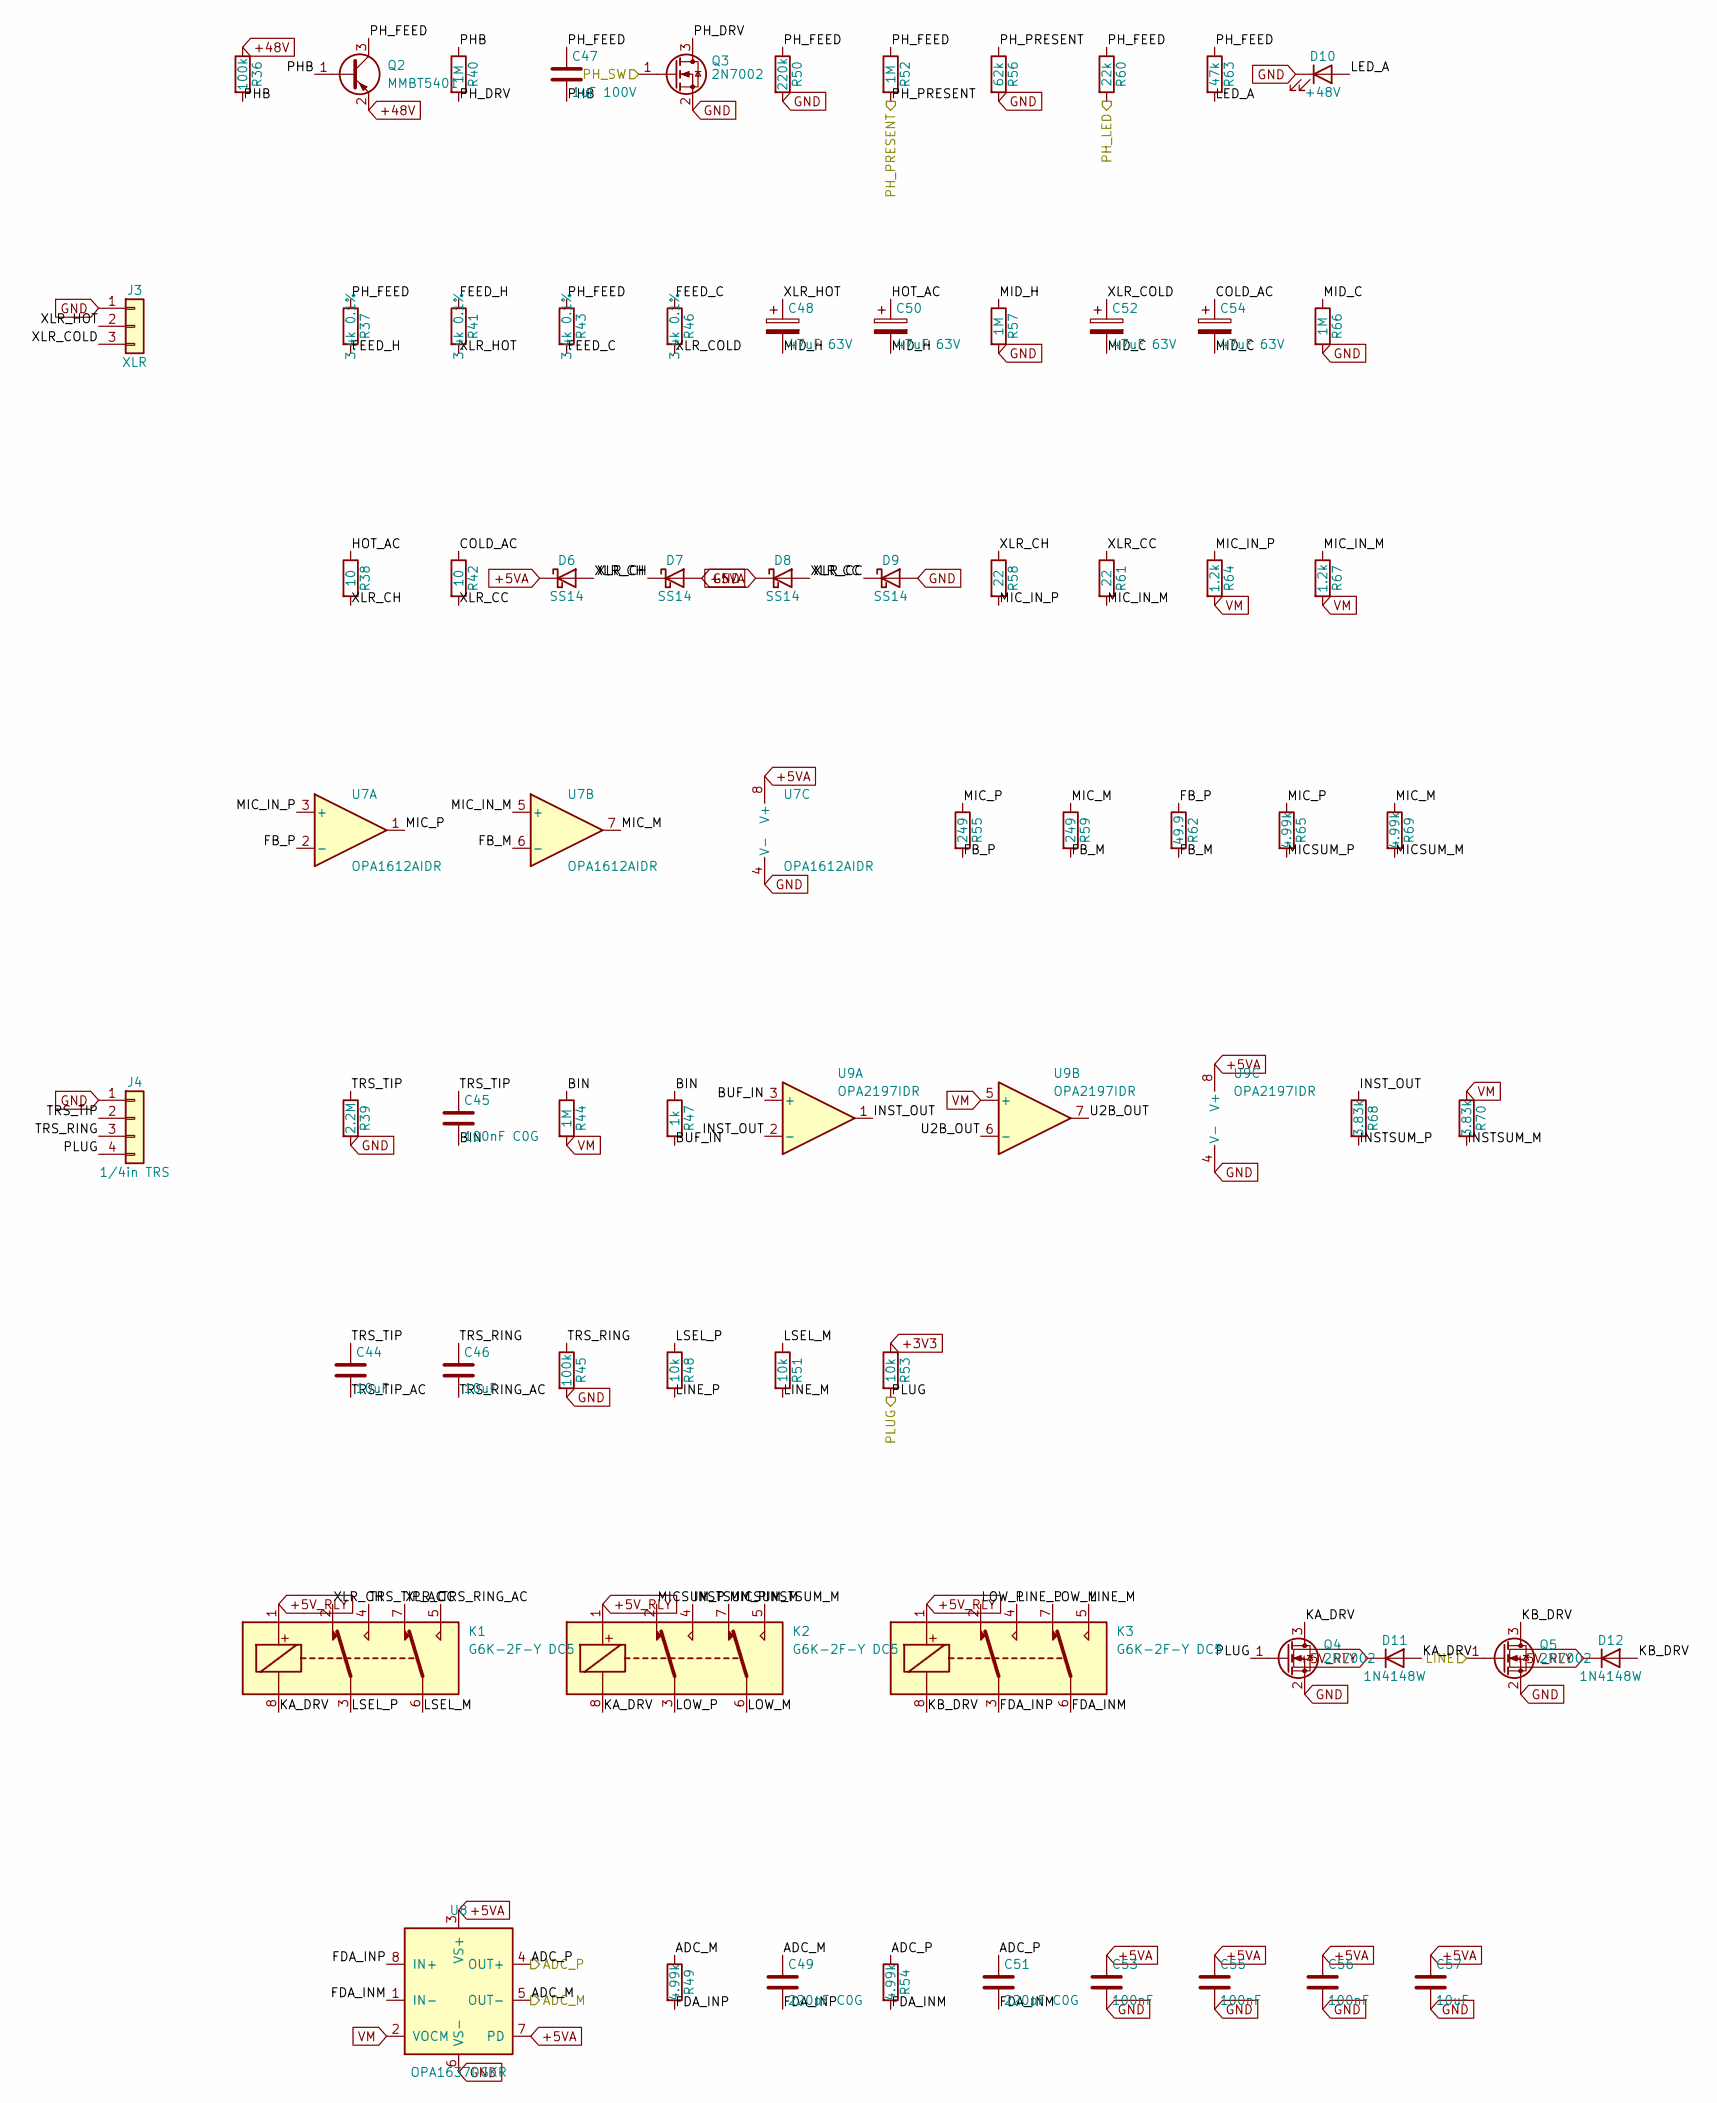
[picture p13: schematic input.kicad_sch]

Parts:
C44, C46, C57: 10uF; C_0805_2012Metric; MPN CL21A106KAYNNNE; LCSC C15850
C45: 100nF C0G; C_1206_3216Metric; MPN GRM31C5C1H104JA01L; LCSC C97946
C47: 1uF 100V; C_1206_3216Metric; MPN CL31B105KCHNNNE; LCSC C13832
C48, C50, C52, C54: 47uF 63V; CP_Elec_6.3x7.7; MPN RV63V47M6X8; LCSC C48971005
C49, C51: 220pF C0G; C_0603_1608Metric; MPN GCM1885C2A221JA16D; LCSC C388907
C53, C55, C56: 100nF; C_0603_1608Metric; MPN CC0603KRX7R9BB104; LCSC C14663
D6, D7, D8, D9: SS14; D_SMA; MPN SS14; LCSC C2480
D10: +48V; LED_0603_1608Metric; MPN KT-0603R; LCSC C2286
D11, D12: 1N4148W; D_SOD-123; MPN 1N4148W; LCSC C81598
J3: XLR; JST_XH_B3B-XH-A_1x03_P2.50mm_Vertical; MPN B3B-XH-A(LF)(SN); LCSC C144394
J4: 1/4in TRS; JST_XH_B4B-XH-A_1x04_P2.50mm_Vertical; MPN B4B-XH-A(LF)(SN); LCSC C144395
K1, K2, K3: G6K-2F-Y DC5; Relay_DPDT_Omron_G6K-2F-Y; MPN G6K-2F-Y DC5; LCSC C231389
Q2: MMBT5401; SOT-23; MPN MMBT5401; LCSC C8326
Q3, Q4, Q5: 2N7002; SOT-23; MPN 2N7002; LCSC C8545
R36, R45: 100k; R_0603_1608Metric; MPN 0603WAF1003T5E; LCSC C25803
R37, R41, R43, R46: 3.4k 0.1%; R_1206_3216Metric; MPN RT1206BRD073K4L; LCSC C870711
R38, R42: 10; R_0603_1608Metric; MPN 0603WAF100JT5E; LCSC C22859
R39: 2.2M; R_0603_1608Metric; MPN 0603WAF2204T5E; LCSC C22938
R40, R44, R52, R57, R66: 1M; R_0603_1608Metric; MPN 0603WAF1004T5E; LCSC C22935
R47: 1k; R_0603_1608Metric; MPN 0603WAF1001T5E; LCSC C21190
R48, R51, R53: 10k; R_0603_1608Metric; MPN 0603WAF1002T5E; LCSC C25804
R49, R54, R65, R69: 4.99k; R_0603_1608Metric; MPN 0603WAF4991T5E; LCSC C23046
R50: 220k; R_0603_1608Metric; MPN 0603WAF2203T5E; LCSC C22961
R55, R59: 249; R_0603_1608Metric; MPN FRC0603F2490TS; LCSC C2933176
R56: 62k; R_0603_1608Metric; MPN 0603WAF6202T5E; LCSC C23221
R58, R61: 22; R_0603_1608Metric; MPN 0603WAF220JT5E; LCSC C23345
R60: 22k; R_1206_3216Metric; MPN FRC1206F2202TS; LCSC C2907375
R62: 49.9; R_0603_1608Metric; MPN 0603WAF499JT5E; LCSC C23185
R63: 47k; R_1206_3216Metric; MPN RC1206FR-0747KL; LCSC C137270
R64, R67: 1.2k; R_0603_1608Metric; MPN 0603WAF1201T5E; LCSC C22765
R68, R70: 3.83k; R_0603_1608Metric; MPN FRC0603F3831TS; LCSC C2933213
U7: OPA1612AIDR; SOIC-8_3.9x4.9mm_P1.27mm; MPN OPA1612AIDR; LCSC C94590
U8: OPA1637DGKR; VSSOP-8_3x3mm_P0.65mm; MPN OPA1637DGKR; LCSC C2860968
U9: OPA2197IDR; SOIC-8_3.9x4.9mm_P1.27mm; MPN OPA2197IDR; LCSC C139363

Connections:
+3V3: R53.1
+5VA: C53.1, C55.1, C56.1, C57.1, D6.1 (K), D8.1 (K), U7.8 (V+), U8.3 (VS+), U8.7 (PD), U9.8 (V+)
+5V_RLY: D11.1 (K), D12.1 (K), K1.1, K2.1, K3.1
+48V: Q2.2 (E), R36.1
ADC_M: C49.1, R49.1, U8.5 (OUT-)
ADC_P: C51.1, R54.1, U8.4 (OUT+)
BIN: C45.2, R44.1, R47.1
BUF_IN: R47.2, U9.3 (+)
COLD_AC: C54.1, R42.1
FB_M: R59.2, R62.2, U7.6 (-)
FB_P: R55.2, R62.1, U7.2 (-)
FDA_INM: C51.2, K3.6, R54.2, U8.1 (IN-)
FDA_INP: C49.2, K3.3, R49.2, U8.8 (IN+)
FEED_C: R43.2, R46.1
FEED_H: R37.2, R41.1
GND: C53.2, C55.2, C56.2, C57.2, D7.2 (A), D9.2 (A), D10.1 (K), J3.1, J4.1, Q3.2 (S), Q4.2 (S), Q5.2 (S), R39.2, R45.2, R50.2, R56.2, R57.2, R66.2, U7.4 (V-), U8.6 (VS-), U9.4 (V-)
HOT_AC: C50.1, R38.1
INSTSUM_M: K2.5, R70.2
INSTSUM_P: K2.4, R68.2
INST_OUT: R68.1, U9.1, U9.2 (-)
KA_DRV: D11.2 (A), K1.8, K2.8, Q4.3 (D)
KB_DRV: D12.2 (A), K3.8, Q5.3 (D)
LED_A: D10.2 (A), R63.2
LINE: Q5.1 (G)
LINE_M: K3.5, R51.2
LINE_P: K3.4, R48.2
LOW_M: K2.6, K3.7
LOW_P: K2.3, K3.2
LSEL_M: K1.6, R51.1
LSEL_P: K1.3, R48.1
MICSUM_M: K2.7, R69.2
MICSUM_P: K2.2, R65.2
MIC_IN_M: R61.2, R67.1, U7.5 (+)
MIC_IN_P: R58.2, R64.1, U7.3 (+)
MIC_M: R59.1, R69.1, U7.7
MIC_P: R55.1, R65.1, U7.1
MID_C: C52.2, C54.2, R66.1
MID_H: C48.2, C50.2, R57.1
PHB: C47.2, Q2.1 (B), R36.2, R40.1
PH_DRV: Q3.3 (D), R40.2
PH_FEED: C47.1, Q2.3 (C), R37.1, R43.1, R50.1, R52.1, R60.1, R63.1
PH_LED: R60.2
PH_PRESENT: R52.2, R56.1
PH_SW: Q3.1 (G)
PLUG: J4.4, Q4.1 (G), R53.2
TRS_RING: C46.1, J4.3, R45.1
TRS_RING_AC: C46.2, K1.5
TRS_TIP: C44.1, C45.1, J4.2, R39.1
TRS_TIP_AC: C44.2, K1.4
U2B_OUT: U9.6 (-), U9.7
VM: R44.2, R64.2, R67.2, R70.1, U8.2 (VOCM), U9.5 (+)
XLR_CC: D8.2 (A), D9.1 (K), K1.7, R42.2, R61.1
XLR_CH: D6.2 (A), D7.1 (K), K1.2, R38.2, R58.1
XLR_COLD: C52.1, J3.3, R46.2
XLR_HOT: C48.1, J3.2, R41.2
