pedal-science/pedal-codec/hardware/output.kicad_sch

## KiCad design hardware/output.kicad_sch (2026-11-14, an earlier design)

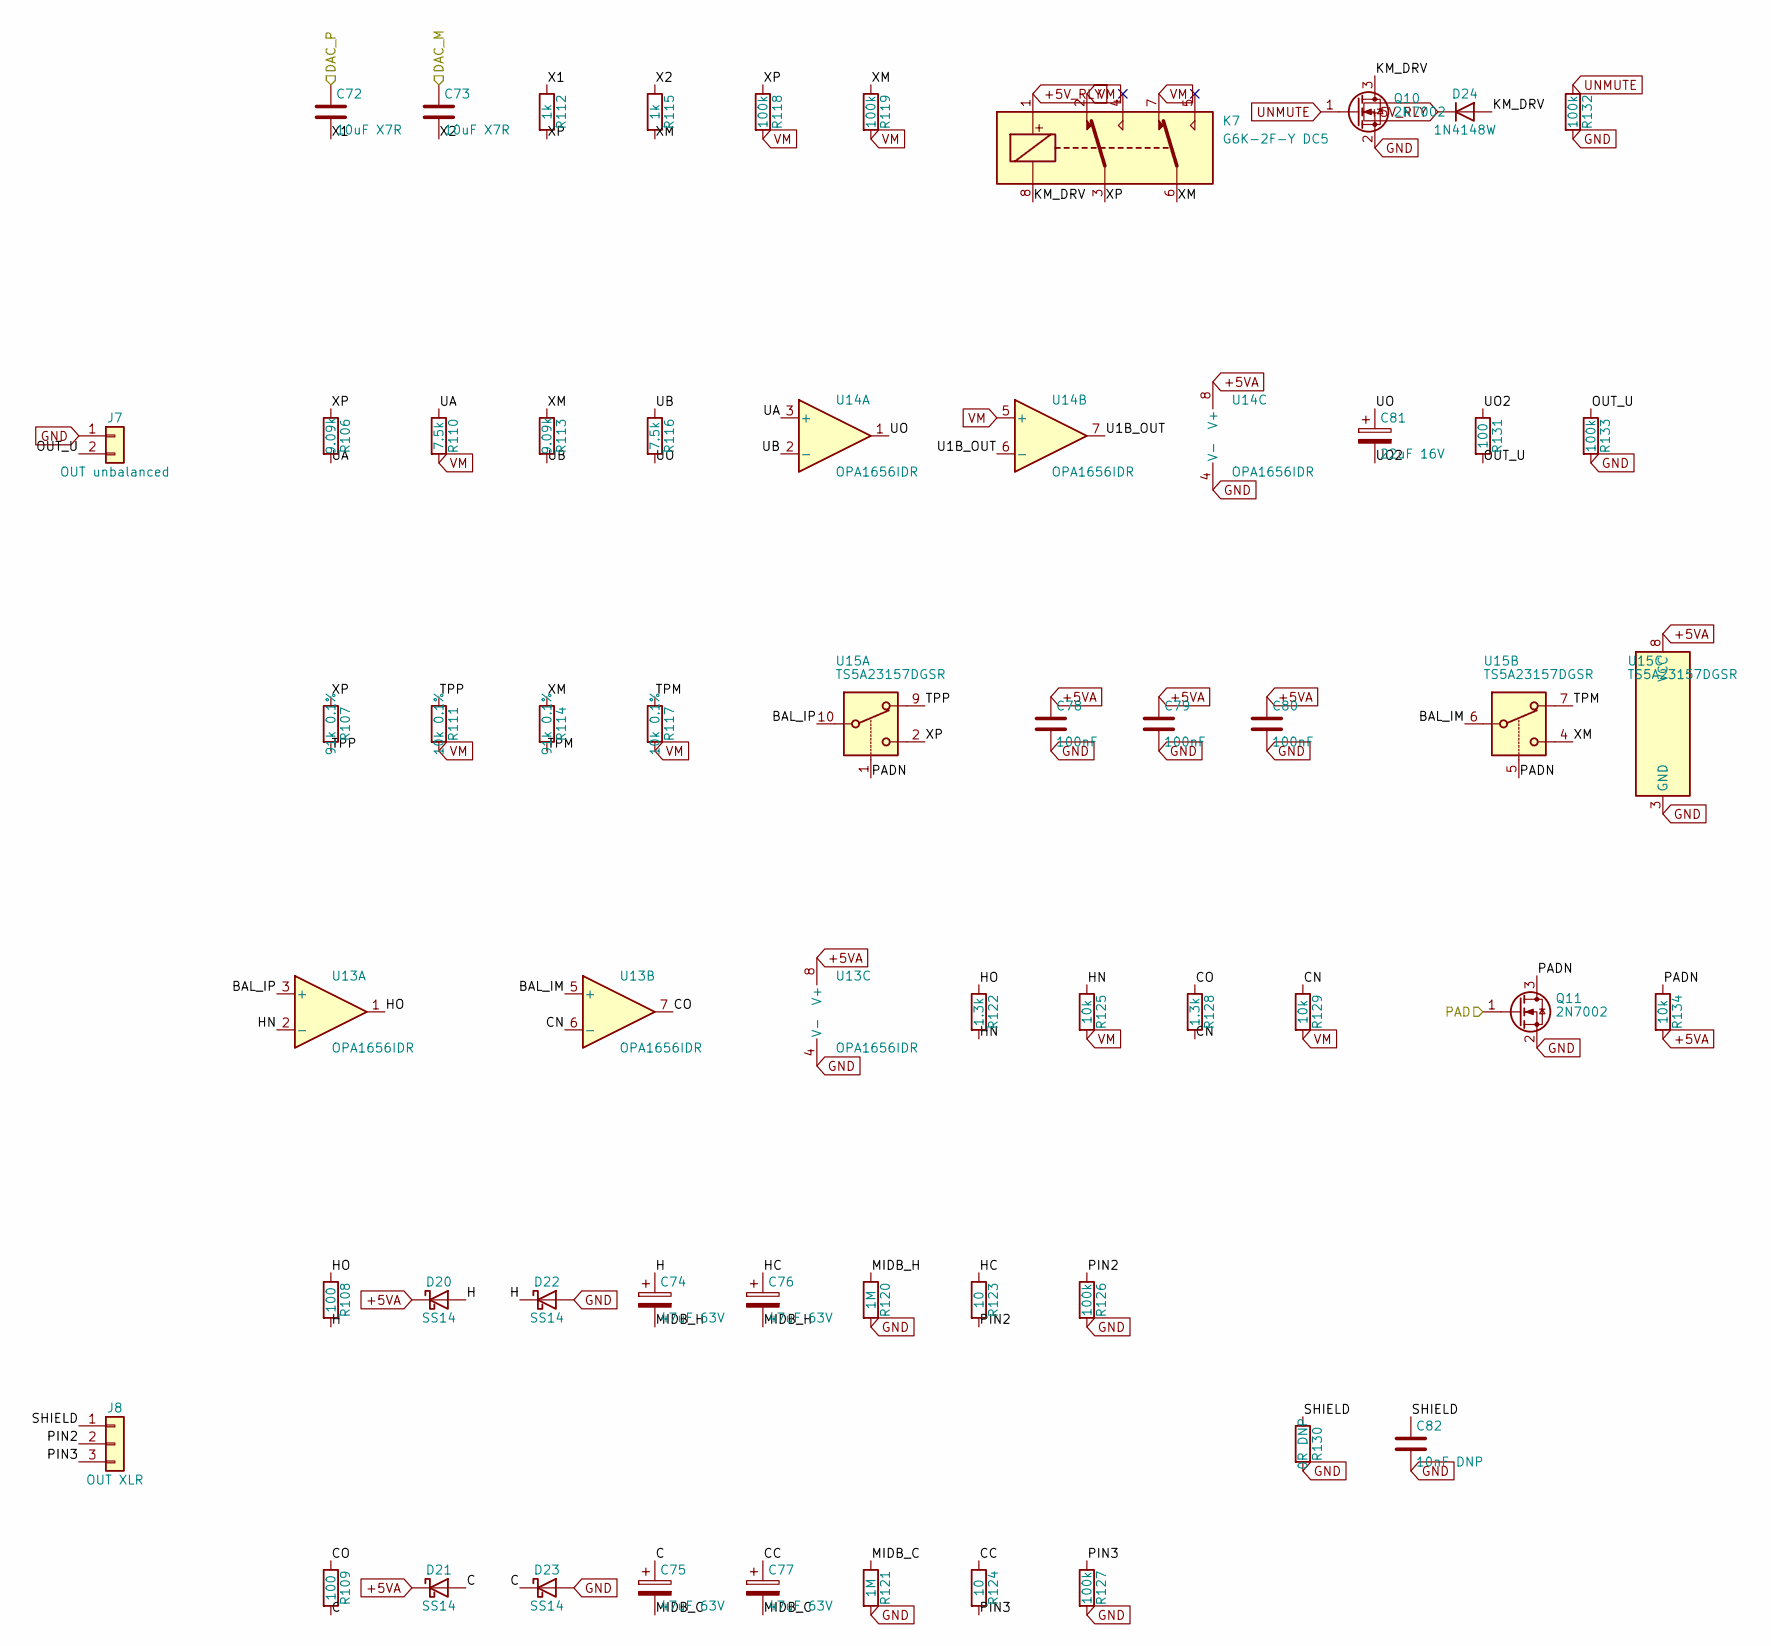
[picture p14: schematic output.kicad_sch]

Parts:
C72, C73: 10uF X7R; C_1206_3216Metric; MPN CL31B106KAHNNNE; LCSC C14860
C74, C75, C76, C77: 47uF 63V; CP_Elec_6.3x7.7; MPN RV63V47M6X8; LCSC C48971005
C78, C79, C80: 100nF; C_0603_1608Metric; MPN CC0603KRX7R9BB104; LCSC C14663
C81: 22uF 16V; CP_Elec_5x5.4; MPN EFVH016ADA220M0554; LCSC C22387968
C82: 10nF DNP; C_0603_1608Metric; MPN 0603B103K500NT; LCSC C57112
D20, D21, D22, D23: SS14; D_SMA; MPN SS14; LCSC C2480
D24: 1N4148W; D_SOD-123; MPN 1N4148W; LCSC C81598
J7: OUT unbalanced; JST_XH_B2B-XH-A_1x02_P2.50mm_Vertical; MPN B2B-XH-A(LF)(SN); LCSC C158012
J8: OUT XLR; JST_XH_B3B-XH-A_1x03_P2.50mm_Vertical; MPN B3B-XH-A(LF)(SN); LCSC C144394
K7: G6K-2F-Y DC5; Relay_DPDT_Omron_G6K-2F-Y; MPN G6K-2F-Y DC5; LCSC C231389
Q10, Q11: 2N7002; SOT-23; MPN 2N7002; LCSC C8545
R106, R113: 9.09k; R_0603_1608Metric; MPN 0603WAF9091T5E; LCSC C23125
R107, R114: 91k 0.1%; R_0603_1608Metric; MPN RT0603BRD0791KL; LCSC C326721
R108, R109, R131: 100; R_0603_1608Metric; MPN 0603WAF1000T5E; LCSC C22775
R110, R116: 7.5k; R_0603_1608Metric; MPN 0603WAF7501T5E; LCSC C23234
R111, R117: 10k 0.1%; R_0603_1608Metric; MPN RT0603BRD0710KL; LCSC C95204
R112, R115: 1k; R_0603_1608Metric; MPN 0603WAF1001T5E; LCSC C21190
R118, R119, R126, R127, R132, R133: 100k; R_0603_1608Metric; MPN 0603WAF1003T5E; LCSC C25803
R120, R121: 1M; R_0603_1608Metric; MPN 0603WAF1004T5E; LCSC C22935
R122, R128: 1.3k; R_0603_1608Metric; MPN 0603WAF1301T5E; LCSC C22767
R123, R124: 10; R_0603_1608Metric; MPN 0603WAF100JT5E; LCSC C22859
R125, R129, R134: 10k; R_0603_1608Metric; MPN 0603WAF1002T5E; LCSC C25804
R130: 0R DNP; R_0603_1608Metric; MPN 0603WAF0000T5E; LCSC C21189
U13, U14: OPA1656IDR; SOIC-8_3.9x4.9mm_P1.27mm; MPN OPA1656IDR; LCSC C1849431
U15: TS5A23157DGSR; TSSOP-10_3x3mm_P0.5mm; MPN TS5A23157DGSR; LCSC C11133

Connections:
+5VA: C78.1, C79.1, C80.1, D20.1 (K), D21.1 (K), R134.2, U13.8 (V+), U14.8 (V+), U15.8 (VCC)
+5V_RLY: D24.1 (K), K7.1
BAL_IM: U13.5 (+), U15.6
BAL_IP: U13.3 (+), U15.10
C: C75.1, D21.2 (A), D23.1 (K), R109.2
CC: C77.1, R124.1
CN: R128.2, R129.1, U13.6 (-)
CO: R109.1, R128.1, U13.7
DAC_M: C73.1
DAC_P: C72.1
GND: C78.2, C79.2, C80.2, C82.2, D22.2 (A), D23.2 (A), J7.1, Q10.2 (S), Q11.2 (S), R120.2, R121.2, R126.2, R127.2, R130.2, R132.2, R133.2, U13.4 (V-), U14.4 (V-), U15.3 (GND)
H: C74.1, D20.2 (A), D22.1 (K), R108.2
HC: C76.1, R123.1
HN: R122.2, R125.1, U13.2 (-)
HO: R108.1, R122.1, U13.1
KM_DRV: D24.2 (A), K7.8, Q10.3 (D)
MIDB_C: C75.2, C77.2, R121.1
MIDB_H: C74.2, C76.2, R120.1
OUT_U: J7.2, R131.2, R133.1
PAD: Q11.1 (G)
PADN: Q11.3 (D), R134.1, U15.1, U15.5
PIN2: J8.2, R123.2, R126.1
PIN3: J8.3, R124.2, R127.1
SHIELD: C82.1, J8.1, R130.1
TPM: R114.2, R117.1, U15.7
TPP: R107.2, R111.1, U15.9
U1B_OUT: U14.6 (-), U14.7
UA: R106.2, R110.1, U14.3 (+)
UB: R113.2, R116.1, U14.2 (-)
UNMUTE: Q10.1 (G), R132.1
UO: C81.1, R116.2, U14.1
UO2: C81.2, R131.1
VM: K7.2, K7.7, R110.2, R111.2, R117.2, R118.2, R119.2, R125.2, R129.2, U14.5 (+)
X1: C72.2, R112.1
X2: C73.2, R115.1
XM: K7.6, R113.1, R114.1, R115.2, R119.1, U15.4
XP: K7.3, R106.1, R107.1, R112.2, R118.1, U15.2
