pedal-science/pedal-codec/hardware/panel.kicad_sch

## KiCad design hardware/panel.kicad_sch (2026-11-14, an earlier design)

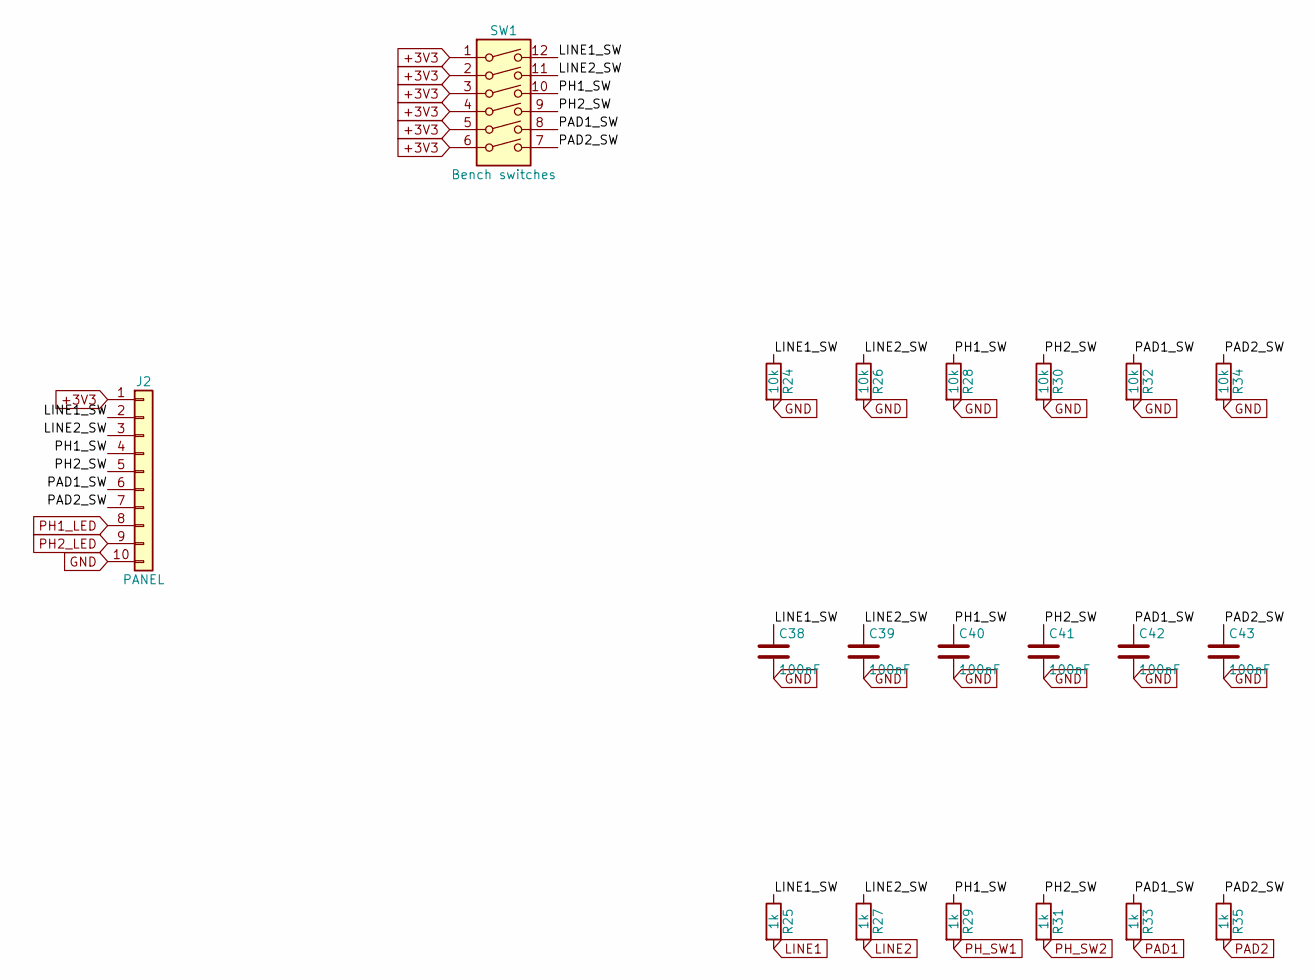
[picture p15: schematic panel.kicad_sch]

Parts:
C38, C39, C40, C41, C42, C43: 100nF; C_0603_1608Metric; MPN CC0603KRX7R9BB104; LCSC C14663
J2: PANEL; JST_XH_B10B-XH-A_1x10_P2.50mm_Vertical; MPN B10B-XH-A(LF)(SN); LCSC C144400
R24, R26, R28, R30, R32, R34: 10k; R_0603_1608Metric; MPN 0603WAF1002T5E; LCSC C25804
R25, R27, R29, R31, R33, R35: 1k; R_0603_1608Metric; MPN 0603WAF1001T5E; LCSC C21190
SW1: Bench switches; SW_DIP_SPSTx06_Slide_6.7x16.8mm_W8.61mm_P2.54mm_LowProfile; MPN SMXS-06K-TP; LCSC C5439765

Connections:
+3V3: J2.1, SW1.1, SW1.2, SW1.3, SW1.4, SW1.5, SW1.6
GND: C38.2, C39.2, C40.2, C41.2, C42.2, C43.2, J2.10, R24.2, R26.2, R28.2, R30.2, R32.2, R34.2
LINE1: R25.2
LINE1_SW: C38.1, J2.2, R24.1, R25.1, SW1.12
LINE2: R27.2
LINE2_SW: C39.1, J2.3, R26.1, R27.1, SW1.11
PAD1: R33.2
PAD1_SW: C42.1, J2.6, R32.1, R33.1, SW1.8
PAD2: R35.2
PAD2_SW: C43.1, J2.7, R34.1, R35.1, SW1.7
PH1_LED: J2.8
PH1_SW: C40.1, J2.4, R28.1, R29.1, SW1.10
PH2_LED: J2.9
PH2_SW: C41.1, J2.5, R30.1, R31.1, SW1.9
PH_SW1: R29.2
PH_SW2: R31.2
