pedal-science/pedal-codec/hardware/phantom.kicad_sch

## KiCad design hardware/phantom.kicad_sch (2026-11-14, an earlier design)

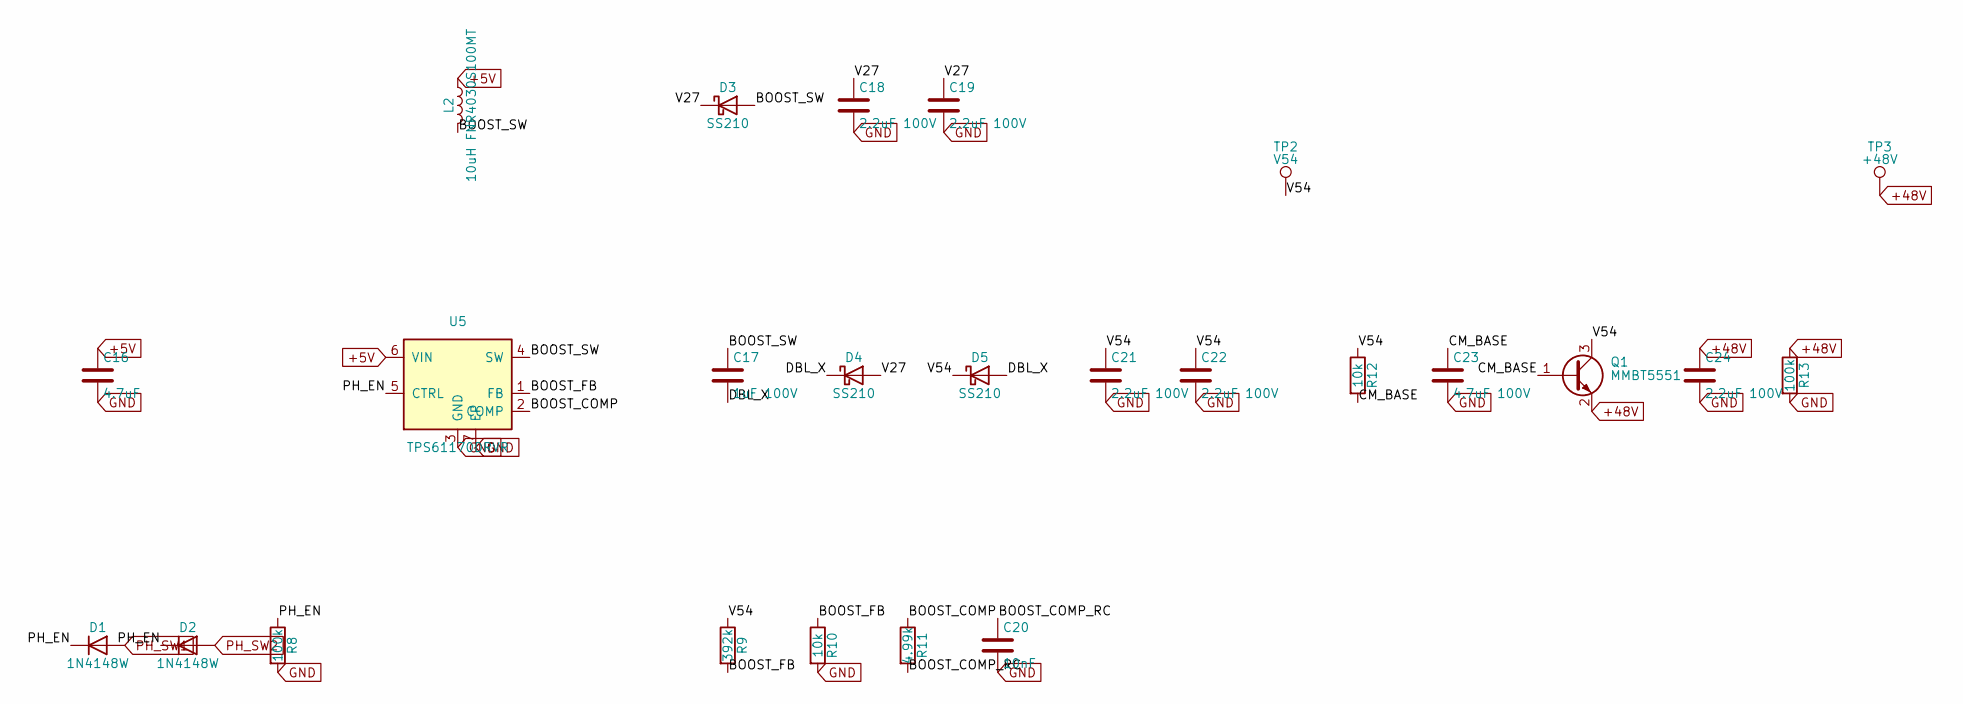
[picture p16: schematic phantom.kicad_sch]

Parts:
C16: 4.7uF; C_0805_2012Metric; MPN CL21A475KAQNNNE; LCSC C1779
C17: 1uF 100V; C_1206_3216Metric; MPN CL31B105KCHNNNE; LCSC C13832
C18, C19, C21, C22, C24: 2.2uF 100V; C_1210_3225Metric; MPN FS32X225K101EGG; LCSC C153036
C20: 10nF; C_0603_1608Metric; MPN 0603B103K500NT; LCSC C57112
C23: 4.7uF 100V; C_1210_3225Metric; MPN FS32X475K101EGG; LCSC C381466
D1, D2: 1N4148W; D_SOD-123; MPN 1N4148W; LCSC C81598
D3, D4, D5: SS210; D_SMA; MPN SS210; LCSC C14996
L2: 10uH FNR4030S100MT; L_Changjiang_FNR4030S; MPN FNR4030S100MT; LCSC C167879
Q1: MMBT5551; SOT-23; MPN MMBT5551; LCSC C2145
R8, R13: 100k; R_0603_1608Metric; MPN 0603WAF1003T5E; LCSC C25803
R9: 392k; R_0603_1608Metric; MPN RCA03392KFLF; LCSC C22369707
R10, R12: 10k; R_0603_1608Metric; MPN 0603WAF1002T5E; LCSC C25804
R11: 4.99k; R_0603_1608Metric; MPN 0603WAF4991T5E; LCSC C23046
TP2: V54; TestPoint_Pad_D1.0mm; MPN PCB test pad; LCSC none
TP3: +48V; TestPoint_Pad_D1.0mm; MPN PCB test pad; LCSC none
U5: TPS61170DRVR; WSON-6-1EP_2x2mm_P0.65mm_EP1x1.6mm_ThermalVias; MPN TPS61170DRVR; LCSC C15163

Connections:
+5V: C16.1, L2.1, U5.6 (VIN)
+48V: C24.1, Q1.2 (E), R13.1, TP3.1
BOOST_COMP: R11.1, U5.2 (COMP)
BOOST_COMP_RC: C20.1, R11.2
BOOST_FB: R9.2, R10.1, U5.1 (FB)
BOOST_SW: C17.1, D3.2 (A), L2.2, U5.4 (SW)
CM_BASE: C23.1, Q1.1 (B), R12.2
DBL_X: C17.2, D4.1 (K), D5.2 (A)
GND: C16.2, C18.2, C19.2, C20.2, C21.2, C22.2, C23.2, C24.2, R8.2, R10.2, R13.2, U5.3 (GND), U5.7 (EP)
PH_EN: D1.1 (K), D2.1 (K), R8.1, U5.5 (CTRL)
PH_SW1: D1.2 (A)
PH_SW2: D2.2 (A)
V27: C18.1, C19.1, D3.1 (K), D4.2 (A)
V54: C21.1, C22.1, D5.1 (K), Q1.3 (C), R9.1, R12.1, TP2.1
