pedal-science/pedal-codec/hardware/power.kicad_sch

## KiCad design hardware/power.kicad_sch (2026-11-14, an earlier design)

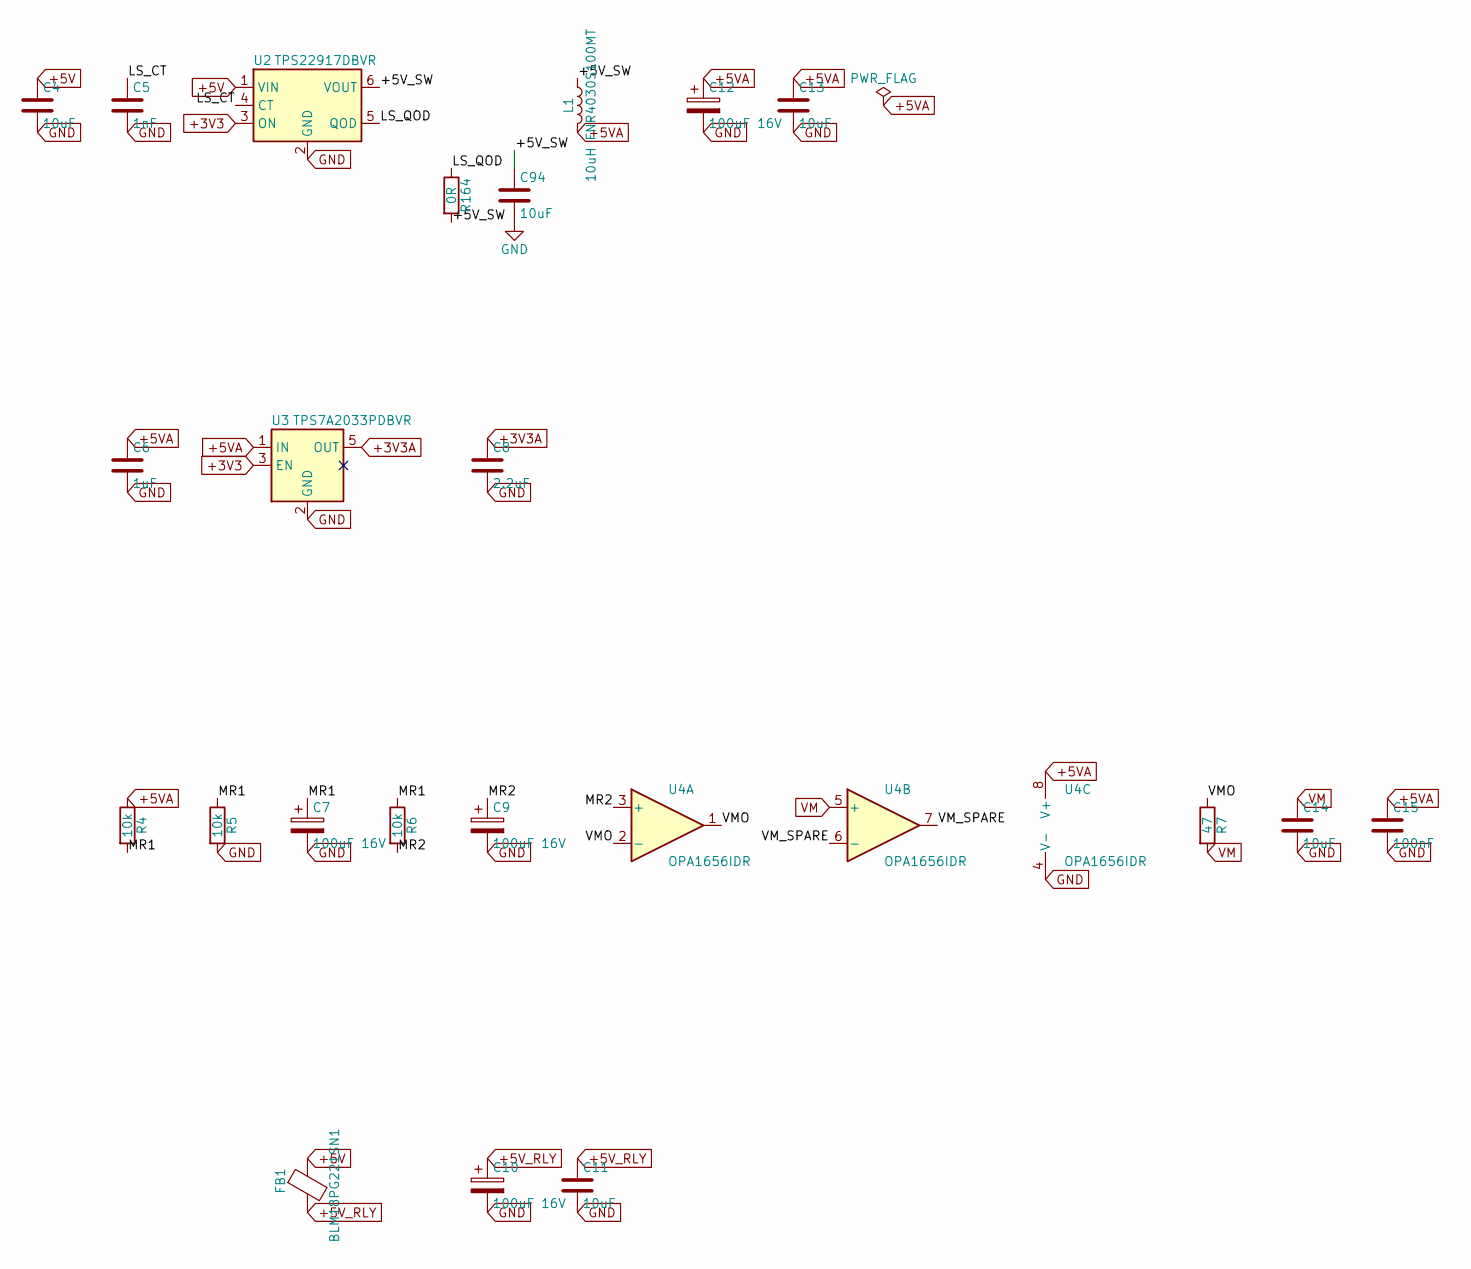
[picture p17: schematic power.kicad_sch]

Parts:
C4, C11, C13, C14, C94: 10uF; C_0805_2012Metric; MPN CL21A106KAYNNNE; LCSC C15850
C5: 1nF; C_0603_1608Metric; MPN CL10B102KB8NNNC; LCSC C1588
C6: 1uF; C_0603_1608Metric; MPN CL10A105KA8NNNC; LCSC C5673
C7, C9, C10, C12: 100uF 16V; CP_Elec_6.3x5.4; MPN RVT100UF16V67RV0016; LCSC C2887276
C8: 2.2uF; C_0603_1608Metric; MPN CL10A225KO8NNNC; LCSC C23630
C15: 100nF; C_0603_1608Metric; MPN CC0603KRX7R9BB104; LCSC C14663
FB1: BLM18PG221SN1; L_0603_1608Metric; MPN BLM18PG221SN1D; LCSC C80165
L1: 10uH FNR4030S100MT; L_Changjiang_FNR4030S; MPN FNR4030S100MT; LCSC C167879
R4, R5, R6: 10k; R_0603_1608Metric; MPN 0603WAF1002T5E; LCSC C25804
R7: 47; R_0603_1608Metric; MPN 0603WAF470JT5E; LCSC C23182
R164: 0R; R_0603_1608Metric; MPN 0603WAF0000T5E; LCSC C21189
U2: TPS22917DBVR; SOT-23-6; MPN TPS22917DBVR; LCSC C2681320
U3: TPS7A2033PDBVR; SOT-23-5; MPN TPS7A2033PDBVR; LCSC C2862740
U4: OPA1656IDR; SOIC-8_3.9x4.9mm_P1.27mm; MPN OPA1656IDR; LCSC C1849431

Connections:
+3V3: U2.3 (ON), U3.3 (EN)
+3V3A: C8.1, U3.5 (OUT)
+5V: C4.1, FB1.1, U2.1 (VIN)
+5VA: C6.1, C12.1, C13.1, C15.1, L1.2, R4.1, U3.1 (IN), U4.8 (V+)
+5V_RLY: C10.1, C11.1, FB1.2
+5V_SW: C94.1, L1.1, R164.2, U2.6 (VOUT)
GND: C4.2, C5.2, C6.2, C7.2, C8.2, C9.2, C10.2, C11.2, C12.2, C13.2, C14.2, C15.2, C94.2, R5.2, U2.2 (GND), U3.2 (GND), U4.4 (V-)
LS_CT: C5.1, U2.4 (CT)
LS_QOD: R164.1, U2.5 (QOD)
MR1: C7.1, R4.2, R5.1, R6.1
MR2: C9.1, R6.2, U4.3 (+)
VM: C14.1, R7.2, U4.5 (+)
VMO: R7.1, U4.1, U4.2 (-)
VM_SPARE: U4.6 (-), U4.7
