pedal-science/pedal-codec/(commit log)

2026-11-11 Start pedal-codec: a Pi audio HAT around the TAC5242
    The requirements as the owner gave them, what the TAC5242's datasheet
    changes about them (pin control, no gain, a fixed 2 Vrms differential
    full scale, no MCLK needed), the board's blocks with the questions still
    open, and the phases from decisions to measured boards, each with the
    tools it uses and its done-when.
2026-11-11 The owner's four answers: 3-pin inputs, Mic mode, HAT+, 5 V rail
    Each input now has three modes on two relays, with Instrument as the
    de-energised state and the phantom feed through K1's contact. The mic
    gain is fixed at about 20 dB, because the codec's floor referred
    through that gain already meets a 150 ohm source's own noise. The op-amps
    run from the Pi's 5 V behind a load switch and filter, with a filtered
    mid-rail reference; the header table gains K2 on GPIO 12 and 13.
2026-11-11 Inputs on combo jacks, modes and phantom on panel switches
    Each input's XLR and 1/4in halves now have their own connectors: the
    plug chooses the path, a panel switch chooses Line against Instrument
    (1/4in) or Mic (XLR), and phantom power comes only from a panel switch
    with an LED lit by the feed itself, wired only to the XLR pins. The Pi
    reads every switch and the plug detection but sets none of them; a
    solder jumper lets software drive the Line choice if rigs ever need it.
    No contact touches the 1 MOhm node any more: the relay switches the
    instrument buffer's output.
2026-11-11 Balanced outputs: each output also on an XH 3-pin for a male XLR
    The same audio as the unbalanced 2-pin, live at once, after the pedal's
    own XLR output design (balanced-outputs.md, step 2), with two changes:
    the TAC5242's differential output drives hot and cold through two
    identical followers, so no inverter is needed, and the rail is 5 V,
    which still gives +8.2 dBu at codec full scale. One mute relay per
    output silences both forms. Pin 1 is its own net, for the chassis at
    the socket. The pad is left open.
2026-11-11 Change the codec to the TAC5212
    The TAC5242's I2C-controlled twin, in the same package with the same
    converters, so the Pi configures it in software instead of six strap
    pins: ultra-low-latency filters (about 0.14 ms round trip at 48 kHz,
    passband to 0.325 fS), digital volume and mute, selectable input
    impedance. Its channel gain is digital, so the mic preamp stays. It
    sits on I2C1 at 0x50, its interrupt on GPIO 25, and a local
    oscillator's footprint on GPI1 keeps codec-master as an option. The new
    risk is the Linux driver: TI's, or the tac5x1x series posted upstream,
    which phase 1 now checks.
2026-11-11 Fit the balanced outputs' -20 dB pad, on a panel switch
    Owner's choice. The divider is always fitted; a panel switch, DC only
    like the others, drives a dual analogue switch that picks the full
    signal or the tap at the followers' input, so only the XLR is lowered.
    The Pi reads each pad switch on GPIO 16 and 26. No design question is
    open now: phase 1 starts with the codec's driver.
2026-11-11 Phase 1: driver status, parts with LCSC stock, and the simulations
    The TAC5212 has no Linux driver in mainline or Raspberry Pi's trees, and
    TI's tac5x1x series of March 2026 has review changes outstanding, so v1
    is brought up by writing the codec's registers from userspace over I2C.
    Every part has its LCSC number and stock. The phantom supply is a
    TPS61170 with a doubler on its switch node, since one boost stage can't
    step 5 V to 52 V; the phantom capacitors are 47 uF 63 V pairs back to
    back, since JLCPCB carries no bipolar 63 V part; the feed is two 3.4 k
    0.1 % resistors per leg, to survive a shorted pin.
    sim/sim.py runs ngspice over each input mode, the 5 V rail, both phantom
    faults and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
2026-11-14 Phase 2: the schematic, reviewed
    The KiCad 10 project in hardware/: a root sheet and seven sheets (header
    and EEPROM, power, phantom supply, codec, panel, and the input and output
    channels, each used twice), with LCSC and MPN on every symbol. ERC is
    clean, the netlist joins across every sheet, and hardware/pedal-codec.pdf
    is the export for the owner's review.
    docs/schematic-review.md is the review: the kicad-happy analysis and its
    ngspice run triaged, every finding answered, and each custom symbol's
    pinout checked against its maker's datasheet. It added C94, 10 uF on the
    load switch's output, so the switch turning off with current in L1 can't
    pull VOUT below its -0.3 V limit.
    design.md rec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
    [codec.kicad_sch, hat.kicad_sch, input.kicad_sch, output.kicad_sch, panel.kicad_sch, pedal-codec.kicad_pcb, pedal-codec.kicad_sch, phantom.kicad_sch]
2026-11-14 Redraw the schematic sheets as circuits
    Every sheet now draws its circuit with wires in signal order instead of parts
    on a grid joined by net labels. The netlist is unchanged (238 nets, 352 parts,
    values, footprints, LCSC and MPN), checked part by part; ERC is clean. A few
    channel-sheet designators moved: the inputs' op-amps (U7-U9, U10-U12) and the
    second output's C85, C92 and R163. The PDF is re-exported and the docs follow.
    [codec.kicad_sch, hat.kicad_sch, input.kicad_sch, output.kicad_sch, panel.kicad_sch, phantom.kicad_sch, power.kicad_sch]
2026-11-14 Specify the box board for the pedal's 1590DD case and replan for it
    docs/box-board.md: the owner's brief of 2026-11-14 as requirements (a strip
    under the footswitches on the base plate, a 40-way ribbon to the Pi, one guitar
    and one mic input, a stereo TRS output, the Pico and the controls on the board,
    everything on JST XH), with the questions the schematic needs answered and the
    measurements the fit needs. plan.md phases 3-9 now lead to that board, starting
    with the fit in the case.
2026-11-14 Box board: record the owner's answers
    A combo XLR/TRS mic socket (both halves in parallel), no phantom, bypass at
    rest driven by the RP2350, a switching guitar jack read for plug detect, the
    RP2350 as a chip on the board, one case bond, MIDI in on 3.5 mm TRS Type A,
    and the controls chosen: a KY-040 encoder module (powered from 3.3 V) with a
    35 mm scrubber knob, and a 16 mm metal pushbutton whose LED ring runs from 5 V.
2026-11-14 Box board: choose the parts it adds
    The RP2350A with Raspberry Pi's own regulator inductor and crystal (their
    design guide makes both a condition), a 2 MB flash, an AP2112K for its 3.3 V,
    an H11L1 for MIDI in (it runs from 3.3 V, the 6N138 doesn't), a 2x20 IDC box
    header for the ribbon, and the 4- and 5-pin XH. Stock from the JLCPCB database
    on the day. The sockets in the case wait for phase 3's measurements.
